HerrRiebmann/KDS2Bluetooth/ECU Emulation/Hex Calculator/Resources/AddFile.png

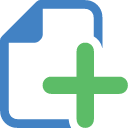
ECU Emulation/Hex Calculator/Resources/AddFile.png
