HerrRiebmann/KDS2Bluetooth/ECU Emulation/Images/Hex Reader.png

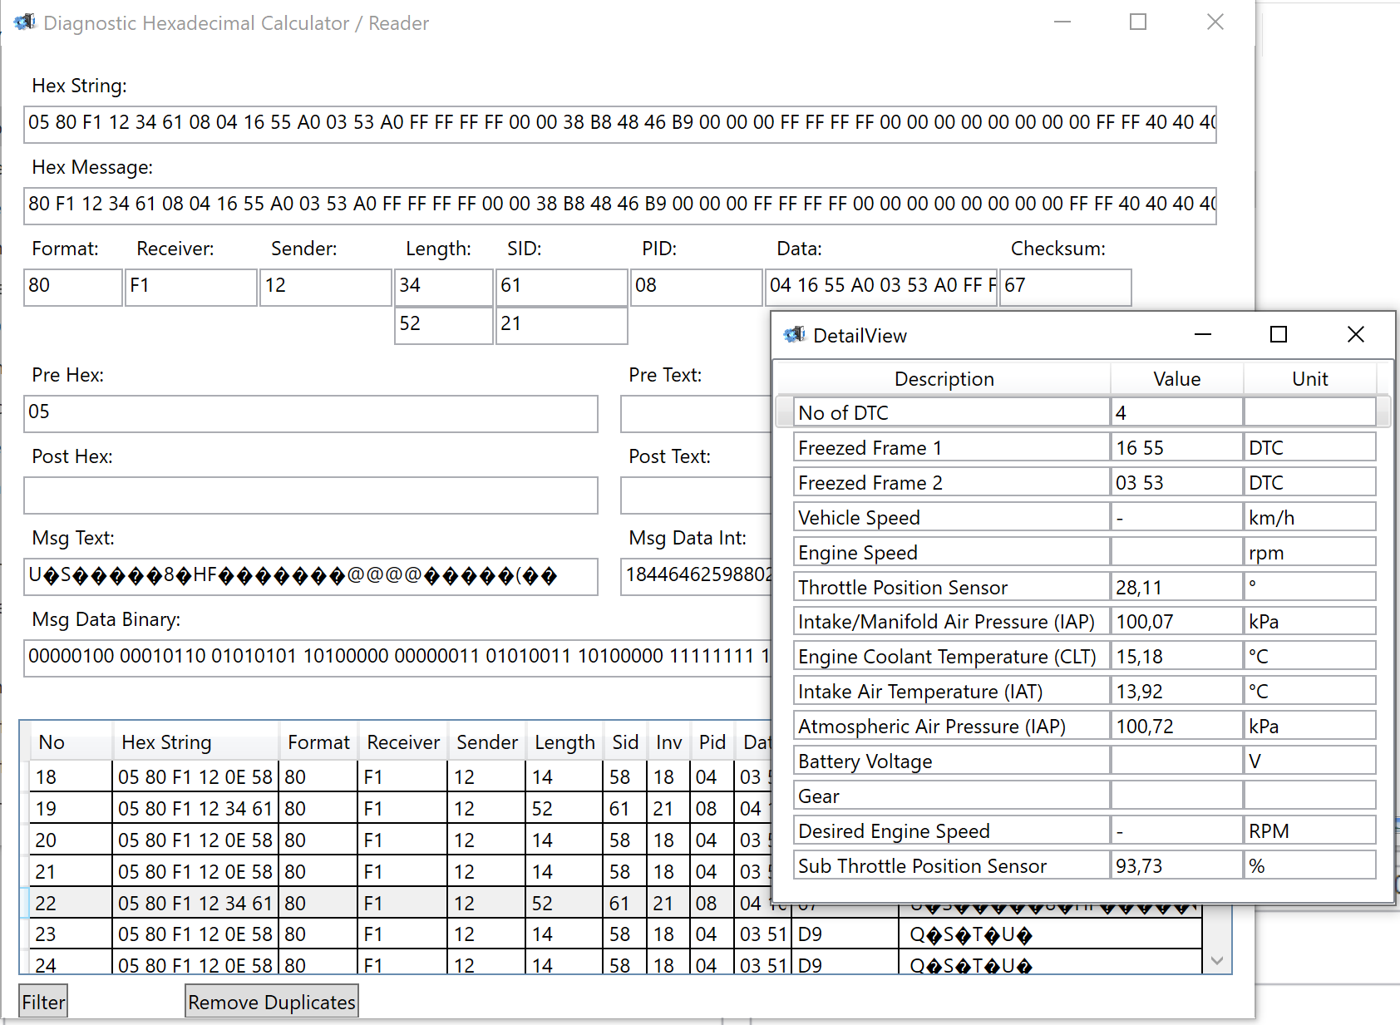
ECU Emulation/Images/Hex Reader.png
