HerrRiebmann/KDS2Bluetooth/ECU Emulation/Images/obd2 compliant.png

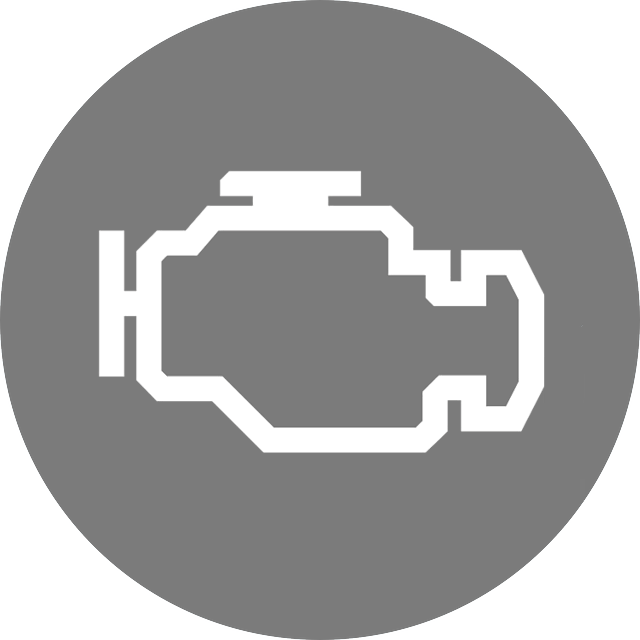
ECU Emulation/Images/obd2 compliant.png
