HerrRiebmann/KDS2Bluetooth/ECU Emulation/Images/vspc-2.gif

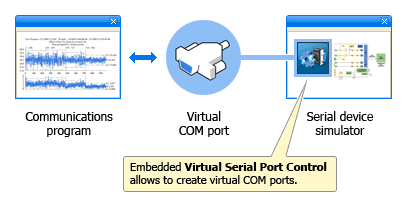
ECU Emulation/Images/vspc-2.gif
