HerrRiebmann/KDS2Bluetooth/Documentation/OBD II PIDs.xlsx

Sheet: Wikipedia
PID (hex) | Data bytes returned | Description | Min value | Max value | Units | Formula[a] (https://en.wikipedia.org/wiki/OBD-II_PIDs) | Number | Kawasaki
0 | 4 | PIDs supported [01 - 20] |  |  |  | Bit encoded [A7..D0] == [PID $01..PID $20] See below (https://en.wikipedia.org/wiki/OBD-II_PIDs)
1 | 4 | Monitor status since DTCs cleared. (Includes malfunction indicator lamp (MIL) status and number of DTCs.) |  |  |  | Bit encoded. See below (https://en.wikipedia.org/wiki/OBD-II_PIDs) | 1 |  | 0
2 | 2 | Freeze DTC |  |  |  |  | 2 |  | 0
3 | 2 | Fuel system status |  |  |  | Bit encoded. See below (https://en.wikipedia.org/wiki/OBD-II_PIDs) | 3 |  | 0
4 | 1 | Calculated engine load value | 0 | 100 | % | A*100/255 | 4 |  | 0
5 | 1 | Engine coolant temperature | -40 | 215 | °C | A-40 | 5 | 6 | 1
6 | 1 | Short term fuel % trim—Bank 1 | -100 Subtracting Fuel (Rich Condition) | 99.22 Adding Fuel (Lean Condition) | % | (A-128) * 100/128 | 6 |  | 0
7 | 1 | Long term fuel % trim—Bank 1 | -100 Subtracting Fuel (Rich Condition) | 99.22 Adding Fuel (Lean Condition) | % | (A-128) * 100/128 | 7 |  | 0
8 | 1 | Short term fuel % trim—Bank 2 | -100 Subtracting Fuel (Rich Condition) | 99.22 Adding Fuel (Lean Condition) | % | (A-128) * 100/128 | 8 |  | 0
9 | 1 | Long term fuel % trim—Bank 2 | -100 Subtracting Fuel (Rich Condition) | 99.22 Adding Fuel (Lean Condition) | % | (A-128) * 100/128 | 9 |  | 0
0A | 1 | Fuel pressure | 0 | 765 | kPa (gauge) | A*3 | 10 |  | 0
0B | 1 | Intake manifold absolute pressure | 0 | 255 | kPa (absolute) | A | 11 | 5 | 1 | ?
0C | 2 | Engine RPM | 0 | 16,383.75 | rpm | ((A*256)+B)/4 | 12 | 9 | 1
0D | 1 | Vehicle speed | 0 | 255 | km/h | A | 13 | 0C | 1
0E | 1 | Timing advance | -64 | 63.5 | ° relative to #1 cylinder | (A-128)/2 | 14 |  | 0
0F | 1 | Intake air temperature | -40 | 215 | °C | A-40 | 15 | 7 | 1
10 | 2 | MAF air flow rate | 0 | 655.35 | grams/sec | ((A*256)+B) / 100 | 16 |  | 0 | ? | Fehlt das Pendant bei Kawa
11 | 1 | Throttle position | 0 | 100 | % | A*100/255 | 17 | 4 | 1
12 | 1 | Commanded secondary air status |  |  |  | Bit encoded. See below (https://en.wikipedia.org/wiki/OBD-II_PIDs) | 18 |  | 0
13 | 1 | Oxygen sensors present |  |  |  | [A0..A3] == Bank 1, Sensors 1-4. [A4..A7] == Bank 2... | 19 |  | 0
14 | 2 | Bank 1, Sensor 1: |  |  | Volts | A/200
 |  | Oxygen sensor voltage, | 0 | 1.275 | % | (B-128) * 100/128 (if B==$FF, sensor is not used in trim calc) | 20 |  | 0
 |  | Short term fuel trim | -100(lean) | 99.2(rich)
15 | 2 | Bank 1, Sensor 2: |  |  | Volts | A/200
 |  | Oxygen sensor voltage, | 0 | 1.275 | % | (B-128) * 100/128 (if B==$FF, sensor is not used in trim calc) | 21 |  | 0
 |  | Short term fuel trim | -100(lean) | 99.2(rich)
16 | 2 | Bank 1, Sensor 3: |  |  | Volts | A/200
 |  | Oxygen sensor voltage, | 0 | 1.275 | % | (B-128) * 100/128 (if B==$FF, sensor is not used in trim calc) | 22 |  | 0
 |  | Short term fuel trim | -100(lean) | 99.2(rich)
17 | 2 | Bank 1, Sensor 4: |  |  | Volts | A/200
 |  | Oxygen sensor voltage, | 0 | 1.275 | % | (B-128) * 100/128 (if B==$FF, sensor is not used in trim calc) | 23 |  | 0
 |  | Short term fuel trim | -100(lean) | 99.2(rich)
18 | 2 | Bank 2, Sensor 1: |  |  | Volts | A/200
 |  | Oxygen sensor voltage, | 0 | 1.275 | % | (B-128) * 100/128 (if B==$FF, sensor is not used in trim calc) | 24 |  | 0
 |  | Short term fuel trim | -100(lean) | 99.2(rich)
19 | 2 | Bank 2, Sensor 2: |  |  | Volts | A/200
 |  | Oxygen sensor voltage, | 0 | 1.275 | % | (B-128) * 100/128 (if B==$FF, sensor is not used in trim calc) | 25 |  | 0
 |  | Short term fuel trim | -100(lean) | 99.2(rich)
1A | 2 | Bank 2, Sensor 3: |  |  | Volts | A/200
 |  | Oxygen sensor voltage, | 0 | 1.275 | % | (B-128) * 100/128 (if B==$FF, sensor is not used in trim calc) | 26 |  | 0
 |  | Short term fuel trim | -100(lean) | 99.2(rich)
1B | 2 | Bank 2, Sensor 4: |  |  | Volts | A/200
 |  | Oxygen sensor voltage, | 0 | 1.275 | % | (B-128) * 100/128 (if B==$FF, sensor is not used in trim calc) | 27 |  | 0
 |  | Short term fuel trim | -100(lean) | 99.2(rich)
1C | 1 | OBD standards this vehicle conforms to |  |  |  | Bit encoded. See below (https://en.wikipedia.org/wiki/OBD-II_PIDs)
1D | 1 | Oxygen sensors present |  |  |  | Similar to PID 13, but [A0..A7] == [B1S1, B1S2, B2S1, B2S2, B3S1, B3S2, B4S1, B4S2] | 28 |  | 0
1E | 1 | Auxiliary input status |  |  |  | A0 == Power Take Off (PTO) status (1 == active) | 29 |  | 0
 |  |  |  |  |  | [A1..A7] not used
1F | 2 | Run time since engine start | 0 | 65.535 | seconds | (A*256)+B | 30 |  | 0
20 | 4 | PIDs supported [21 - 40] |  |  |  | Bit encoded [A7..D0] == [PID $21..PID $40] See below (https://en.wikipedia.org/wiki/OBD-II_PIDs)
21 | 2 | Distance traveled with malfunction indicator lamp (MIL) on | 0 | 65.535 | km | (A*256)+B | 1
22 | 2 | Fuel Rail Pressure (relative to manifold vacuum) | 0 | 5177265 | kPa | ((A*256)+B) * 0.079 | 2
23 | 2 | Fuel Rail Pressure (diesel, or gasoline direct inject) | 0 | 655.35 | kPa (gauge) | ((A*256)+B) * 10 | 3
24 | 4 | O2S1_WR_lambda(1): | 0 | 1999 | N/A | ((A*256)+B)*2/65535 or ((A*256)+B)/32768
 |  | Equivalence Ratio | 0 | 7999 | V | ((C*256)+D)*8/65535 or ((C*256)+D)/8192 | 4
 |  | Voltage
25 | 4 | O2S2_WR_lambda(1): | 0 | 2 | N/A | ((A*256)+B)*2/65535 | 5
 |  | Equivalence Ratio | 0 | 8 | V | ((C*256)+D)*8/65535
 |  | Voltage
26 | 4 | O2S3_WR_lambda(1): | 0 | 2 | N/A | ((A*256)+B)*2/65535
 |  | Equivalence Ratio | 0 | 8 | V | ((C*256)+D)*8/65535 | 6
 |  | Voltage
27 | 4 | O2S4_WR_lambda(1): | 0 | 2 | N/A | ((A*256)+B)*2/65535 | 7
 |  | Equivalence Ratio | 0 | 8 | V | ((C*256)+D)*8/65535
 |  | Voltage
28 | 4 | O2S5_WR_lambda(1): | 0 | 2 | N/A | ((A*256)+B)*2/65535
 |  | Equivalence Ratio | 0 | 8 | V | ((C*256)+D)*8/65535 | 8
 |  | Voltage
29 | 4 | O2S6_WR_lambda(1): | 0 | 2 | N/A | ((A*256)+B)*2/65535
 |  | Equivalence Ratio | 0 | 8 | V | ((C*256)+D)*8/65535 | 9
 |  | Voltage
2A | 4 | O2S7_WR_lambda(1): | 0 | 2 | N/A | ((A*256)+B)*2/65535
 |  | Equivalence Ratio | 0 | 8 | V | ((C*256)+D)*8/65535 | 10
 |  | Voltage
2B | 4 | O2S8_WR_lambda(1): | 0 | 2 | N/A | ((A*256)+B)*2/65535
 |  | Equivalence Ratio | 0 | 8 | V | ((C*256)+D)*8/65535 | 11
 |  | Voltage
2C | 1 | Commanded EGR (https://en.wikipedia.org/wiki/Exhaust_gas_recirculation) | 0 | 100 | % | A*100/255 | 12
2D | 1 | EGR Error | -100 | 99.22 | % | (A-128) * 100/128 | 13
2E | 1 | Commanded evaporative purge | 0 | 100 | % | A*100/255 | 14
2F | 1 | Fuel Level Input | 0 | 100 | % | A*100/255 | 15
30 | 1 | # of warm-ups since codes cleared | 0 | 255 | N/A | A | 16
31 | 2 | Distance traveled since codes cleared | 0 | 65.535 | km | (A*256)+B | 17
32 | 2 | Evap. System Vapor Pressure | -8.192 | 8.192 | Pa | ((A*256)+B)/4 (A and B are two's complement signed) (https://en.wikipedia.org/wiki/Two%27s_complement) | 18
33 | 1 | Barometric pressure | 0 | 255 | kPa (Absolute) | A | 19
34 | 4 | O2S1_WR_lambda(1): | 0 | 1999 | N/A | ((A*256)+B)/32,768 | 20
 |  | Equivalence Ratio | -128 | 127.99 | mA | ((C*256)+D)/256 - 128
 |  | Current
35 | 4 | O2S2_WR_lambda(1): | 0 | 2 | N/A | ((A*256)+B)/32,768 | 21
 |  | Equivalence Ratio | -128 | 128 | mA | ((C*256)+D)/256 - 128
 |  | Current
36 | 4 | O2S3_WR_lambda(1): | 0 | 2 | N/A | ((A*256)+B)/32768
 |  | Equivalence Ratio | -128 | 128 | mA | ((C*256)+D)/256 - 128
 |  | Current
37 | 4 | O2S4_WR_lambda(1): | 0 | 2 | N/A | ((A*256)+B)/32,768 | 22
 |  | Equivalence Ratio | -128 | 128 | mA | ((C*256)+D)/256 - 128
 |  | Current
38 | 4 | O2S5_WR_lambda(1): | 0 | 2 | N/A | ((A*256)+B)/32,768 | 23
 |  | Equivalence Ratio | -128 | 128 | mA | ((C*256)+D)/256 - 128
 |  | Current
39 | 4 | O2S6_WR_lambda(1): | 0 | 2 | N/A | ((A*256)+B)/32,768 | 24
 |  | Equivalence Ratio | -128 | 128 | mA | ((C*256)+D)/256 - 128
 |  | Current
3A | 4 | O2S7_WR_lambda(1): | 0 | 2 | N/A | ((A*256)+B)/32,768 | 25
 |  | Equivalence Ratio | -128 | 128 | mA | ((C*256)+D)/256 - 128
 |  | Current
3B | 4 | O2S8_WR_lambda(1): | 0 | 2 | N/A | ((A*256)+B)/32,768 | 26
 |  | Equivalence Ratio | -128 | 128 | mA | ((C*256)+D)/256 - 128
 |  | Current
3C | 2 | Catalyst Temperature | -40 | 6,513.5 | °C | ((A*256)+B)/10 - 40 | 27
 |  | Bank 1, Sensor 1
3D | 2 | Catalyst Temperature | -40 | 6,513.5 | °C | ((A*256)+B)/10 - 40 | 28
 |  | Bank 2, Sensor 1
3E | 2 | Catalyst Temperature | -40 | 6,513.5 | °C | ((A*256)+B)/10 - 40 | 29
 |  | Bank 1, Sensor 2
3F | 2 | Catalyst Temperature | -40 | 6,513.5 | °C | ((A*256)+B)/10 - 40 | 30
 |  | Bank 2, Sensor 2
40 | 4 | PIDs supported [41 - 60] |  |  |  | Bit encoded [A7..D0] == [PID $41..PID $60] See below (https://en.wikipedia.org/wiki/OBD-II_PIDs)
41 | 4 | Monitor status this drive cycle |  |  |  | Bit encoded. See below (https://en.wikipedia.org/wiki/OBD-II_PIDs) | 1
42 | 2 | Control module voltage | 0 | 65535 | V | ((A*256)+B)/1000 | 2
43 | 2 | Absolute load value | 0 | 25.7 | % | ((A*256)+B)*100/255 | 3
44 | 2 | Fuel/Air commanded equivalence ratio | 0 | 2 | N/A | ((A*256)+B)/32768 | 4
45 | 1 | Relative throttle position | 0 | 100 | % | A*100/255 | 5
46 | 1 | Ambient air temperature | -40 | 215 | °C | A-40 | 6
47 | 1 | Absolute throttle position B | 0 | 100 | % | A*100/255 | 7
48 | 1 | Absolute throttle position C | 0 | 100 | % | A*100/255 | 8
49 | 1 | Accelerator pedal position D | 0 | 100 | % | A*100/255 | 9
4A | 1 | Accelerator pedal position E | 0 | 100 | % | A*100/255 | 10
4B | 1 | Accelerator pedal position F | 0 | 100 | % | A*100/255 | 11
4C | 1 | Commanded throttle actuator | 0 | 100 | % | A*100/255 | 12
4D | 2 | Time run with MIL on | 0 | 65.535 | minutes | (A*256)+B | 13
4E | 2 | Time since trouble codes cleared | 0 | 65.535 | minutes | (A*256)+B | 14
4F | 4 | Maximum value for equivalence ratio, oxygen sensor voltage, oxygen sensor current, and intake manifold absolute pressure | 0, 0, 0, 0 | 255, 255, 255, 2550 | , V, mA, kPa | A, B, C, D*10 | 15
50 | 4 | Maximum value for air flow rate from mass air flow sensor | 0 | 2550 | g/s | A*10, B, C, and D are reserved for future use | 16
51 | 1 | Fuel Type |  |  |  | From fuel type table see below (https://en.wikipedia.org/wiki/OBD-II_PIDs) | 17
52 | 1 | Ethanol fuel % | 0 | 100 | % | A*100/255 | 18
53 | 2 | Absolute Evap system Vapor Pressure | 0 | 327675 | kPa | ((A*256)+B)/200 | 19
54 | 2 | Evap system vapor pressure | -32.767 | 32.768 | Pa | ((A*256)+B)-32767 | 20
55 | 2 | Short term secondary oxygen sensor trim bank 1 and bank 3 | -100 | 99.22 | % | (A-128)*100/128 | 21
 |  |  |  |  |  | (B-128)*100/128
56 | 2 | Long term secondary oxygen sensor trim bank 1 and bank 3 | -100 | 99.22 | % | (A-128)*100/128 | 22
 |  |  |  |  |  | (B-128)*100/128
57 | 2 | Short term secondary oxygen sensor trim bank 2 and bank 4 | -100 | 99.22 | % | (A-128)*100/128 | 23
 |  |  |  |  |  | (B-128)*100/128
58 | 2 | Long term secondary oxygen sensor trim bank 2 and bank 4 | -100 | 99.22 | % | (A-128)*100/128 | 24
 |  |  |  |  |  | (B-128)*100/128
59 | 2 | Fuel rail pressure (absolute) | 0 | 655.35 | kPa | ((A*256)+B) * 10 | 25
5A | 1 | Relative accelerator pedal position | 0 | 100 | % | A*100/255 | 26
5B | 1 | Hybrid battery pack remaining life | 0 | 100 | % | A*100/255 | 27
5C | 1 | Engine oil temperature | -40 | 210 | °C | A - 40 | 28
5D | 2 | Fuel injection timing | -210.00 | 301992 | ° | (((A*256)+B)-26,880)/128 | 29
5E | 2 | Engine fuel rate | 0 | 3212.75 | L/h | ((A*256)+B)*0.05 | 30 |  | ?
5F | 1 | Emission requirements to which vehicle is designed |  |  |  | Bit Encoded | 31
60 | 4 | PIDs supported [61 - 80] |  |  |  | Bit encoded [A7..D0] == [PID $61..PID $80] See below (https://en.wikipedia.org/wiki/OBD-II_PIDs)
61 | 1 | Driver's demand engine - percent torque | -125 | 125 | % | A-125 | 1
62 | 1 | Actual engine - percent torque | -125 | 125 | % | A-125 | 2 |  | ?
63 | 2 | Engine reference torque | 0 | 65.535 | Nm | A*256+B | 3
64 | 5 | Engine percent torque data | -125 | 125 | % | A-125 Idle
 |  |  |  |  |  | B-125 Engine point 1 | 4
 |  |  |  |  |  | C-125 Engine point 2
 |  |  |  |  |  | D-125 Engine point 3
 |  |  |  |  |  | E-125 Engine point 4
65 | 2 | Auxiliary input / output supported |  |  |  | Bit Encoded | 5
66 | 5 | Mass air flow sensor |  |  |  |  | 6
67 | 3 | Engine coolant temperature |  |  |  |  | 7
68 | 7 | Intake air temperature sensor |  |  |  |  | 8
69 | 7 | Commanded EGR and EGR Error |  |  |  |  | 9
6A | 5 | Commanded Diesel intake air flow control and relative intake air flow position |  |  |  |  | 10
6B | 5 | Exhaust gas recirculation temperature |  |  |  |  | 11
6C | 5 | Commanded throttle actuator control and relative throttle position |  |  |  |  | 12
6D | 6 | Fuel pressure control system |  |  |  |  | 13
6E | 5 | Injection pressure control system |  |  |  |  | 14
6F | 3 | Turbocharger compressor inlet pressure |  |  |  |  | 15
70 | 9 | Boost pressure control |  |  |  |  | 16
71 | 5 | Variable Geometry turbo (VGT) control |  |  |  |  | 17
72 | 5 | Wastegate control |  |  |  |  | 18
73 | 5 | Exhaust pressure |  |  |  |  | 19
74 | 5 | Turbocharger RPM |  |  |  |  | 20
75 | 7 | Turbocharger temperature |  |  |  |  | 21
76 | 7 | Turbocharger temperature |  |  |  |  | 22
77 | 5 | Charge air cooler temperature (CACT) |  |  |  |  | 23
78 | 9 | Exhaust Gas temperature (EGT) Bank 1 |  |  |  | Special PID. See below (https://en.wikipedia.org/wiki/OBD-II_PIDs) | 24
79 | 9 | Exhaust Gas temperature (EGT) Bank 2 |  |  |  | Special PID. See below (https://en.wikipedia.org/wiki/OBD-II_PIDs) | 25
7A | 7 | Diesel particulate filter (DPF) |  |  |  |  | 26
7B | 7 | Diesel particulate filter (DPF) |  |  |  |  | 27
7C | 9 | Diesel Particulate filter (DPF) temperature |  |  |  |  | 28
7D | 1 | NOx NTE control area status |  |  |  |  | 29
7E | 1 | PM NTE control area status |  |  |  |  | 30
7F | 13 | Engine run time
80 | 4 | PIDs supported [81 - A0] |  |  |  | Bit encoded [A7..D0] == [PID $81..PID $A0] See below (https://en.wikipedia.org/wiki/OBD-II_PIDs)
81 | 21 | Engine run time for Auxiliary Emissions Control Device(AECD) |  |  |  |  | 1
82 | 21 | Engine run time for Auxiliary Emissions Control Device(AECD) |  |  |  |  | 2
83 | 5 | NOx sensor |  |  |  |  | 3
84 |  | Manifold surface temperature |  |  |  |  | 4
85 |  | NOx reagent system |  |  |  |  | 5
86 |  | Particulate matter (PM) sensor |  |  |  |  | 6
87 |  | Intake manifold absolute pressure |  |  |  |  | 7
A0 | 4 | PIDs supported [A1 - C0] |  |  |  | Bit encoded [A7..D0] == [PID $A1..PID $C0] See below (https://en.wikipedia.org/wiki/OBD-II_PIDs) | 8
C0 | 4 | PIDs supported [C1 - E0] |  |  |  | Bit encoded [A7..D0] == [PID $C1..PID $E0] See below (https://en.wikipedia.org/wiki/OBD-II_PIDs) | 9
C3 | ? | ? | ? | ? | ? | Returns numerous data, including Drive Condition ID and Engine Speed* | 10
C4 | ? | ? | ? | ? | ? | B5 is Engine Idle Request | 11
 |  |  |  |  |  | B6 is Engine Stop Request*

Sheet: OBD II PID
PID | No. | Description | Data bytes returned | Min value | Max value | Units | Formula[a] | Kawasaki PID | Garmin Virb
0 | 0 | List of PIDs supported (range 01 to 32) | 4 |  |  |  | Bit encoded [A7..D0] == [PID $01..PID $20] See below
1 | 1 | Status since the last clearing of fault codes | 4 |  |  |  | Bit encoded. See below |  |  | 0
2 | 2 | Fault code that caused the recording of "freeze frame" data | 2 |  |  |  |  |  |  | 0
3 | 3 | Fuel system status | 2 |  |  |  | Bit encoded. See below |  |  | 0
4 | 4 | Engine load calculated in % | 1 | 0 | 100 | % | A*100/255 |  | X | 1
5 | 5 | Temperature of the engine coolant in Â°C | 1 | -40 | 215 | °C | A-40 | 6 | X | 1
6 | 6 | Short-term fuel % trim bank 1 | 1 | -100 Subtracting Fuel (Rich Condition) | 99.22 Adding Fuel (Lean Condition) | % | (A-128) * 100/128 |  |  | 0
7 | 7 | Long-term fuel % trim bank 1 | 1 | -100 Subtracting Fuel (Rich Condition) | 99.22 Adding Fuel (Lean Condition) | % | (A-128) * 100/128 |  |  | 0
8 | 8 | Short-term fuel % trim bank 2 | 1 | -100 Subtracting Fuel (Rich Condition) | 99.22 Adding Fuel (Lean Condition) | % | (A-128) * 100/128 |  |  | 0
9 | 9 | Long-term fuel % trim bank 2 | 1 | -100 Subtracting Fuel (Rich Condition) | 99.22 Adding Fuel (Lean Condition) | % | (A-128) * 100/128 |  |  | 0
0A | 10 | Fuel pressure in kPa | 1 | 0 | 765 | kPa (gauge) | A*3 |  |  | 0
0B | 11 | Intake manifold absolute pressure in kPa | 1 | 0 | 255 | kPa (absolute) | A | 5 |  | 0
0C | 12 | Engine speed in rpm | 2 | 0 | 16,383.75 | rpm | ((A*256)+B)/4 | 9 | X | 1
0D | 13 | Vehicle speed in kph | 1 | 0 | 255 | km/h | A | 0C | X | 1
0E | 14 | Timing advance on cylinder 1 in degrees | 1 | -64 | 63.5 | ° relative to #1 cylinder | (A-128)/2 |  |  | 0
0F | 15 | Intake air temperature in Â°C | 1 | -40 | 215 | °C | A-40 | 7 | X | 1
10 | 16 | Air flow measured by the flowmeter in g/s | 2 | 0 | 655.35 | grams/sec | ((A*256)+B) / 100 | MAF | X | 1
11 | 17 | Throttle position in % | 1 | 0 | 100 | % | A*100/255 | 4 | X | 1
12 | 18 | Status of the secondary intake circuit | 1 |  |  |  | Bit encoded. See below |  |  | 0
13 | 19 | O2 sensor positions bank/sensor | 1 |  |  |  | [A0..A3] == Bank 1, Sensors 1-4. [A4..A7] == Bank 2... |  |  | 0
14 | 20 | Oxygen sensor volts bank 1 sensor 1 | 2 | 0 | 1.275 | % | (B-128) * 100/128 (if B==$FF, sensor is not used in trim calc) |  |  | 0
15 | 21 | Oxygen sensor volts bank 1 sensor 2 | 2 | 0 | 1.275 | % | (B-128) * 100/128 (if B==$FF, sensor is not used in trim calc) |  |  | 0
16 | 22 | Oxygen sensor volts bank 1 sensor 3 | 2 | 0 | 1.275 | % | (B-128) * 100/128 (if B==$FF, sensor is not used in trim calc) |  |  | 0
17 | 23 | Oxygen sensor volts bank 1 sensor 4 | 2 | 0 | 1.275 | % | (B-128) * 100/128 (if B==$FF, sensor is not used in trim calc) |  |  | 0
18 | 24 | Oxygen sensor volts bank 2 sensor 1 | 2 | 0 | 1.275 | % | (B-128) * 100/128 (if B==$FF, sensor is not used in trim calc) |  |  | 0
19 | 25 | Oxygen sensor volts bank 2 sensor 2 | 2 | 0 | 1.275 | % | (B-128) * 100/128 (if B==$FF, sensor is not used in trim calc) |  |  | 0
1A | 26 | Oxygen sensor volts bank 2 sensor 3 | 2 | 0 | 1.275 | % | (B-128) * 100/128 (if B==$FF, sensor is not used in trim calc) |  |  | 0
1B | 27 | Oxygen sensor volts bank 2 sensor 4 | 2 | 0 | 1.275 | % | (B-128) * 100/128 (if B==$FF, sensor is not used in trim calc) |  |  | 0
1C | 28 | OBD computer specification | 1 |  |  |  |  |  |  | 0
1D | 29 | O2 sensor positions bank/sensor | 1 |  |  |  | Similar to PID 13, but [A0..A7] == [B1S1, B1S2, B2S1, B2S2, B3S1, B3S2, B4S1, B4S2] |  |  | 0
1E | 30 | Auxiliary input status | 1 |  |  |  | A0 == Power Take Off (PTO) status (1 == active) |  |  | 0
1F | 31 | Run time since engine start | 2 | 0 | 65.535 | seconds | (A*256)+B |  |  | 0
20 | 32 | List of PIDs supported (range 33 to 64) | 4 |  |  |  | Bit encoded [A7..D0] == [PID $21..PID $40] See below |  |  | 1 | 4100181B8001
21 | 33 | Distance travelled with MIL on in kms | 2 | 0 | 65.535 | km | (A*256)+B |  |  | 0
22 | 34 | Relative fuel rail pressure in kPa | 2 | 0 | 5177265 | kPa | ((A*256)+B) * 0.079 |  |  | 0
23 | 35 | Fuel rail pressure in kPa | 2 | 0 | 655.35 | kPa (gauge) | ((A*256)+B) * 10 |  |  | 0
24 | 36 | O2 sensor (extended range) bank 1, sensor 1 (lambda and volts) | 4 | 0 | 7999 | V | ((C*256)+D)*8/65535 or ((C*256)+D)/8192 |  |  | 0
25 | 37 | O2 sensor (extended range) bank 1, sensor 2 (lambda and volts) | 4 | 0 | 8 | V | ((C*256)+D)*8/65535 |  |  | 0
26 | 38 | O2 sensor (extended range) bank 1, sensor 3 (lambda and volts) | 4 | 0 | 8 | V | ((C*256)+D)*8/65535 |  |  | 0
27 | 39 | O2 sensor (extended range) bank 1, sensor 4 (lambda and volts) | 4 | 0 | 8 | V | ((C*256)+D)*8/65535 |  |  | 0
28 | 40 | O2 sensor (extended range) bank 2, sensor 1 (lambda and volts) | 4 | 0 | 8 | V | ((C*256)+D)*8/65535 |  |  | 0
29 | 41 | O2 sensor (extended range) bank 2, sensor 2 (lambda and volts) | 4 | 0 | 8 | V | ((C*256)+D)*8/65535 |  |  | 0
2A | 42 | O2 sensor (extended range) bank 2, sensor 3 (lambda and volts) | 4 | 0 | 8 | V | ((C*256)+D)*8/65535 |  |  | 0
2B | 43 | O2 sensor (extended range) bank 2, sensor 4 (lambda and volts) | 4 | 0 | 8 | V | ((C*256)+D)*8/65535 |  |  | 0
2C | 44 | EGR in % | 1 | 0 | 100 | % | A*100/255 |  |  | 0
2D | 45 | EGR error in % | 1 | -100 | 99.22 | % | (A-128) * 100/128 |  |  | 0
2E | 46 | Evaporation purge in % | 1 | 0 | 100 | % | A*100/255 |  |  | 0
2F | 47 | Fuel level in % | 1 | 0 | 100 | % | A*100/255 |  |  | 0
30 | 48 | Number of warning(s) since faults (DTC) were cleared | 1 | 0 | 255 | N/A | A |  |  | 0
31 | 49 | Distance since faults (DTC) were cleared. | 2 | 0 | 65.535 | km | (A*256)+B |  |  | 0
32 | 50 | Evaporation system vapour pressure in Pa | 2 | -8.192 | 8.192 | Pa | ((A*256)+B)/4 (A and B are two's complement signed) |  |  | 0
33 | 51 | Barometic pressure in kPa | 1 | 0 | 255 | kPa (Absolute) | A |  |  | 0
34 | 52 | O2 sensor (extended range) bank 1, sensor 1 (lambda and volts) | 4 | -128 | 127.99 | mA | ((C*256)+D)/256 - 128 |  |  | 0
35 | 53 | O2 sensor (extended range) bank 1, sensor 2 (lambda and volts) | 4 | -128 | 128 | mA | ((C*256)+D)/256 - 128 |  |  | 0
36 | 54 | O2 sensor (extended range) bank 1, sensor 3 (lambda and volts) | 4 | -128 | 128 | mA | ((C*256)+D)/256 - 128 |  |  | 0
37 | 55 | O2 sensor (extended range) bank 1, sensor 4 (lambda and volts) | 4 | -128 | 128 | mA | ((C*256)+D)/256 - 128 |  |  | 0
38 | 56 | O2 sensor (extended range) bank 2, sensor 1 (lambda and volts) | 4 | -128 | 128 | mA | ((C*256)+D)/256 - 128 |  |  | 0
39 | 57 | O2 sensor (extended range) bank 2, sensor 2 (lambda and volts) | 4 | -128 | 128 | mA | ((C*256)+D)/256 - 128 |  |  | 0
3A | 58 | O2 sensor (extended range) bank 2, sensor 3 (lambda and volts) | 4 | -128 | 128 | mA | ((C*256)+D)/256 - 128 |  |  | 0
3B | 59 | O2 sensor (extended range) bank 2, sensor 4 (lambda and volts) | 4 | -128 | 128 | mA | ((C*256)+D)/256 - 128 |  |  | 0
3C | 60 | Catalyst temperature in Â°C bank 1, sensor 1 | 2 | -40 | 6,513.5 | °C | ((A*256)+B)/10 - 40 |  |  | 0
3D | 61 | Catalyst temperature in Â°C bank 2, sensor 1 | 2 | -40 | 6,513.5 | °C | ((A*256)+B)/10 - 40 |  |  | 0
3E | 62 | Catalyst temperature in Â°C bank 1, sensor 2 | 2 | -40 | 6,513.5 | °C | ((A*256)+B)/10 - 40 |  |  | 0
3F | 63 | Catalyst temperature in Â°C bank 2, sensor 1 | 2 | -40 | 6,513.5 | °C | ((A*256)+B)/10 - 40 |  |  | 0
40 | 64 | List of PIDs supported (range 65 to 96) | 4 |  |  |  | Bit encoded [A7..D0] == [PID $41..PID $60] See below |  |  | 1 | 412000000001
41 | 65 | Monitor status this drive cycle | 4 |  |  |  | Bit encoded. See below |  |  | 0
42 | 66 | Control module voltage in V | 2 | 0 | 65535 | V | ((A*256)+B)/1000 |  |  | 0
43 | 67 | Absolute engine load | 2 | 0 | 25.7 | % | ((A*256)+B)*100/255 |  |  | 0
44 | 68 | Equivalent fuel/air mixture request | 2 | 0 | 2 | N/A | ((A*256)+B)/32768 |  |  | 0
45 | 69 | Relative throttle position in % | 1 | 0 | 100 | % | A*100/255 |  | X | 1
46 | 70 | Ambient air temperature in Â°C | 1 | -40 | 215 | °C | A-40 |  |  | 0
47 | 71 | Absolute throttle position B in % | 1 | 0 | 100 | % | A*100/255 |  |  | 0
48 | 72 | Absolute throttle position C in % | 1 | 0 | 100 | % | A*100/255 |  |  | 0
49 | 73 | Accelerator pedal position D in % | 1 | 0 | 100 | % | A*100/255 |  |  | 0
4A | 74 | Accelerator pedal position E in % | 1 | 0 | 100 | % | A*100/255 |  |  | 0
4B | 75 | Accelerator pedal position F in % | 1 | 0 | 100 | % | A*100/255 |  |  | 0
4C | 76 | Commanded throttle actuator in % | 1 | 0 | 100 | % | A*100/255 |  |  | 0
4D | 77 | Engine run time since MIL on in min | 2 | 0 | 65.535 | minutes | (A*256)+B |  |  | 0
4E | 78 | Engine run time since faults cleared in min | 2 | 0 | 65.535 | minutes | (A*256)+B |  |  | 0
4F | 79 | Exteral test equipment no. 1 configuration information | 4 | 0, 0, 0, 0 | 255, 255, 255, 2550 | , V, mA, kPa | A, B, C, D*10 |  |  | 0
50 | 80 | Exteral test equipment no. 2 configuration information | 4 | 0 | 2550 | g/s | A*10, B, C, and D are reserved for future use |  |  | 0
51 | 81 | Fuel type used by the vehicle | 1 |  |  |  | From fuel type table see below |  |  | 0
52 | 82 | Ethanol fuel % | 1 | 0 | 100 | % | A*100/255 |  |  | 0
53 | 83 | Absolute evaporation system vapour pressure in kPa | 2 | 0 | 327675 | kPa | ((A*256)+B)/200 |  |  | 0
54 | 84 | Evaporation system vapour pressure in Pa | 2 | -32.767 | 32.768 | Pa | ((A*256)+B)-32767 |  |  | 0
55 | 85 | Short-term O2 sensor trim bank 1 and 3 | 2 | -100 | 99.22 | % | (A-128)*100/128 |  |  | 0
56 | 86 | Long-term O2 sensor trim bank 1 and 3 | 2 | -100 | 99.22 | % | (A-128)*100/128 |  |  | 0
57 | 87 | Short-term O2 sensor trim bank 2 and 4 | 2 | -100 | 99.22 | % | (A-128)*100/128 |  |  | 0
58 | 88 | Long-term O2 sensor trim bank 2 and 4 | 2 | -100 | 99.22 | % | (A-128)*100/128 |  |  | 0
59 | 89 | Absolute fuel rail pressure in kPa | 2 | 0 | 655.35 | kPa | ((A*256)+B) * 10 |  |  | 0
5A | 90 | Relative accelerator pedal position in % | 1 | 0 | 100 | % | A*100/255 |  |  | 0
5B | 91 | Battery unit remaining life (hybrid) in % | 1 | 0 | 100 | % | A*100/255 |  |  | 0
5C | 92 | Engine oil temperature in Â°C | 1 | -40 | 210 | °C | A - 40 |  |  | 0
5D | 93 | Fuel injection timing in Â° | 2 | -210.00 | 301992 | ° | (((A*256)+B)-26,880)/128 |  |  | 0
5E | 94 | Fuel consumption in litre/hr | 2 | 0 | 3212.75 | L/h | ((A*256)+B)*0.05 |  |  | 0
5F | 95 | Fuel consumption in litre/hr | 1 |  |  |  | Bit Encoded |  |  | 0
60 | 96 | List of PIDs supported (range 97 to 128) | 4 |  |  |  | Bit encoded [A7..D0] == [PID $61..PID $80] See below |  |  | 1 | 414008000000
61 | 97 | Driver demand: torque percentage (%) | 1 | -125 | 125 | % | A-125
62 | 98 | Final engine torque percentage (%) | 1 | -125 | 125 | % | A-125
63 | 99 | Engine torque reference in Nm | 2 | 0 | 65.535 | Nm | A*256+B
64 | 100 | Engine torque data in % | 5 | -125 | 125 | % | A-125 Idle
65 | 101 | Auxiliary inputs / outputs | 2 |  |  |  | Bit Encoded
66 | 102 | Flowmeter sensor | 5
67 | 103 | Engine water temperature in Â°C | 3
68 | 104 | Air temperature sensor in Â°C | 7
69 | 105 | Commanded EGR and EGR error | 7
6A | 106 | Commanded Diesel intake air flow control and relative intake air flow position | 5
6B | 107 | Recirculation gas temperature in Â°C | 5
6C | 108 | Commanded throttle actuator control and relative throttle position | 5
6D | 109 | Fuel pressure control system | 6
6E | 110 | Injection pressure control system | 5
6F | 111 | Turbocharger compressor inlet pressure in kPa | 3
70 | 112 | Boost pressure control in kPa | 9
71 | 113 | Variable Geometry turbo (VGT) control | 5
72 | 114 | Wastegate control | 5
73 | 115 | Exhaust pressure in kPa | 5
74 | 116 | Turbocharger RPM | 5
75 | 117 | Turbocharger A temperature in Â°C | 7
76 | 118 | Turbocharger B temperature in Â°C | 7
77 | 119 | Charge air cooler temperature in Â°C | 5
78 | 120 | Exhaust Gas temperature (EGT) Bank 1 | 9
79 | 121 | Exhaust Gas temperature (EGT) Bank 2 | 9
7A | 122 | Diesel particulate filter (DPF) bank 1 | 7
7B | 123 | Diesel particulate filter (DPF) bank 2 | 7
7C | 124 | Diesel Particulate filter (DPF) temperature | 9
7D | 125 | NOx NTE control area status | 1
7E | 126 | PM NTE control area status | 1
7F | 127 | Engine run time | 13
80 | 128 | List of PIDs supported (range 129 to 160) | 4
81 |  | Engine run time for Auxiliary Emissions Control Device(AECD) | 21
82 |  | Engine run time for Auxiliary Emissions Control Device(AECD) | 21
83 |  | NOx sensor | 5
84 |  | Manifold surface temperature | ?
85 |  | NOx reagent system | ?
86 |  | Particulate matter (PM) sensor | ?
87 |  | Intake manifold absolute pressure | ?
A0 |  | PIDs supported [A1 - C0] | 4
C0 |  | PIDs supported [C1 - E0] | 4
C3 |  | ? | ?
C4 |  | ? | ?

Sheet: KDS PID
PID | Description | Data bytes returned | Formula | Unit | Request | Response | Supported Z1000 | Supported Z750r | Operating Range
0 | List of PIDs supported1-32 | 4 |  |  | 80 11 F1 02 21 00 A5 | 80 F1 11 06 61 00 DF F7 87 87 CD
1 | Offen | 1 |  |  | 80 11 F1 02 21 01 A6 | 80 F1 11 02 61 01 05 ?? | 1 | 1
2 | Starter Switch | 1 |  | Bool | 80 11 F1 02 21 02 A7 | 80 F1 11 03 61 02 00 E8 | 1 | 1
3 |  |  |  |  |  |  | 0 | 0
4 | Throttle Position Sensor | 2 | ((a-Minimum) *100) / (Maximum - Minimum) | % | 80 11 F1 02 21 04 A9 | 80 F1 11 04 61 04 00 DE C9 | 1 | 1 | 0.2 ∼ 4.8 V | Min. 201, Max. 405 |  | (100/255)*Value
5 | Air Pressure (Inlet / Manifold) | 2 | ((a * 100) + b) / 2 | Pa | 80 11 F1 02 21 05 AD | 80 F1 11 04 61 05 7F 80 EB | 1 | 1 | Pv = 100 ∼ 900 mmHg
6 | Engine Coolant Temperature | 1 | (a - 48) / 1.6 | C | 80 11 F1 02 21 06 AB | 80 F1 11 03 61 06 70 5C | 1 | 1 | Tw = – 30 ∼ + 120°C
7 | Intake Air Temperature | 1 | (a - 48) / 1.6 | C | 80 11 F1 02 21 07 AC | 80 F1 11 03 61 07 45 32 | 1 | 1 | Ta = – 47 ∼ + 178°C
8 | Atmospheric Manifold Pressure | 1 | a / 2 | kPa | 80 11 F1 02 21 08 AD | 80 F1 11 04 61 08 C2 40 F1 | 1 | 1 | Pa = 100 ∼ 900 mmHg |  | Pa 760 mmHg (the standard atmospheric pressure)
9 | Engine RPM | 2 | (a * 100) + b | rpm | 80 11 F1 02 21 09 AE | 80 F1 11 04 61 09 0F 84 83 | 1 | 1
0A | Battery voltage | 1 | a / 12.75 | V | 80 11 F1 02 21 0A AF | 80 F1 11 03 61 0A B5 A5 | 1 | 1
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
81 |  |  |  |  | 80 11 F1 02 21 81 26 | 80 F1 11 03 7f 21 10 35 | 0 | 0
82 |  |  |  |  |  |  | 0 | 0
83 |  |  |  |  |  |  | 0 | 0
84 |  |  |  |  |  |  | 0 | 0
85 |  |  |  |  |  |  | 0 | 0
86 |  |  |  |  |  |  | 0 | 0
87 |  |  |  |  |  |  | 0 | 0
88 |  |  |  |  |  |  | 0 | 0
89 |  |  |  |  | 80 11 F1 02 21 89 2E | 80 F1 11 03 7f 21 10 35 | 0 | 0
8A |  |  |  |  |  |  | 0 | 0
8B |  |  |  |  | 80 11 F1 02 21 8B 30 | 80 F1 11 03 7f 21 10 35 | 0 | 0
8C |  |  |  |  |  |  | 0 | 0
8D |  |  |  |  |  |  | 0 | 0
8E |  |  |  |  |  |  | 0 | 0
8F |  |  |  |  |  |  | 0 | 0
90 |  |  |  |  |  |  | 0 | 0
91 |  |  |  |  |  |  | 0 | 0
92 |  |  |  |  |  |  | 0 | 0
93 |  |  |  |  |  |  | 0 | 0
94 |  |  |  |  |  |  | 0 | 0
95 |  |  |  |  |  |  | 0 | 0
96 |  |  |  |  |  |  | 0 | 0
97 |  |  |  |  |  |  | 0 | 0
98 |  |  |  |  |  |  | 0 | 0
99 |  |  |  |  |  |  | 0 | 0
9A |  |  |  |  |  |  | 0 | 0
9B |  |  |  |  | 80 11 F1 02 21 9B 40 | 80 F1 11 03 61 9B 00 ?? | 0 | 1
9C |  |  |  |  |  |  | 0 | 0
9D |  |  |  |  |  |  | 0 | 0
9E |  |  |  |  |  |  | 0 | 0
9F |  |  |  |  |  |  | 0 | 0
A0 | PIDs supported [A1 - C0] | 4 |  |  | 80 11 F1 02 21 A0 45 | 80 F1 11 06 61 9B 00 00 00 01 ?? | 1 | 1
C0 | PIDs supported [C1 - E0] |  |  |  |  |  | 1
E0 | Offen |  |  |  |  |  | 1

Sheet: Supported PIDs Z1000
PID | Aktiv | Description | Byte | Hex | Request | Response | Decimal
0 |  | List of PIDs supported1-32 | 1101 1111 1111 0111 1000 0111 1000 0111 | DF F7 87 87 | 80 11 F1 02 21 00 A5 | 80 F1 11 06 61 00 DF F7 87 87 CD
1 | 1 | Offen
2 | 1 | Starter Switch |  |  | 80 11 F1 02 21 02 A7 | 80 F1 11 03 61 02 00 E8
3 | 0 | 0
4 | 1 | Throttle Position Sensor |  |  | 80 11 F1 02 21 04 A9 | 80 F1 11 04 61 04 00 DE C9
5 | 1 | Air Pressure (Inlet / Manifold) |  |  | 80 11 F1 02 21 05 AD | 80 F1 11 04 61 05 7F 80 EB | 127 128 | 95
6 | 1 | Engine Coolant Temperature |  |  | 80 11 F1 02 21 06 AB | 80 F1 11 03 61 06 70 5C
7 | 1 | Intake Air Temperature |  |  | 80 11 F1 02 21 07 AC | 80 F1 11 03 61 07 45 32
8 | 1 | Atmospheric Manifold Pressure |  |  | 80 11 F1 02 21 08 AD | 80 F1 11 04 61 08 C2 40 F1 | 194 64 | 96
9 | 1 | Engine RPM |  |  | 80 11 F1 02 21 09 AE | 80 F1 11 04 61 09 0F 84 83
0A | 1 | Battery voltage |  |  | 80 11 F1 02 21 0A AF | 80 F1 11 03 61 0A B5 A5
0B | 1 | Gear Position |  |  | 80 11 F1 02 21 0B B0 | 80 F1 11 03 61 0B 00 F1
0C | 1 | Speed |  |  | 80 11 F1 02 21 0C B1 | 80 F1 11 04 61 0C 00 00 F3
0D | 0 | 0
0E | 1 | Injector #1 operating time |  |  | 80 11 F1 02 21 0E B3 | 80 F1 11 03 7f 21 10 35
0F | 1 | Injector #2 operating time |  |  | 80 11 F1 02 21 0F B4 | 80 F1 11 03 7f 21 10 35
10 | 1 | Injector #3 operating time |  |  | 80 11 F1 02 21 10 B5 | 80 F1 11 03 7f 21 10 35
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
8E | 0 | 0
8F | 0 | 0
90 | 0 | 0
91 | 0 | 0
92 | 0 | 0
93 | 0 | 0
94 | 0 | 0
95 | 0 | 0
96 | 0 | 0
97 | 0 | 0
98 | 0 | 0
99 | 0 | 0
9A | 0 | 0
9B | 1 | 0
9C | 0 | 0
9D | 0 | 0
9E | 0 | 0
9F | 0 | 0
A0 | 1 | PIDs supported [A1 - C0]
C0 |  | PIDs supported [C1 - E0]
C3 |  | #N/A
C4 |  | #N/A

Sheet: Supported PIDs Z750
PID | Aktiv | Description | Byte | Hex | Request | Response |  | Motor an
0 |  | List of PIDs supported1-32 | 1101 1111 1111 0111 1000 0111 1000 0111 | DF F7 87 87 | 80 11 F1 02 21 00 A5 | DF F7 87 87
1 | 1 | Offen |  |  |  | 05 |  | 05
2 | 1 | Starter Switch |  |  | 80 11 F1 02 21 02 A7 | 00
3 | 0 | 0 |  |  |  | Error
4 | 1 | Throttle Position Sensor |  |  | 80 11 F1 02 21 04 A9 | 00 C9 |  | 00 DA | 201 | 218
5 | 1 | Air Pressure (Inlet / Manifold) |  |  | 80 11 F1 02 21 05 AD | 88 | CC | 94 80 | 136 000 | 204 000 | 148 128 | 127 128
6 | 1 | Engine Coolant Temperature |  |  | 80 11 F1 02 21 06 AB | 88 | 44 | 6A
7 | 1 | Intake Air Temperature |  |  | 80 11 F1 02 21 07 AC | 45 | 44 | 45
8 | 1 | Atmospheric Manifold Pressure |  |  | 80 11 F1 02 21 08 AD | CB 80 |  | CB 80 | 203 128 |  |  |  | Ist praktisch gleichzusetzen mit MAF bei Autos
9 | 1 | Engine RPM |  |  | 80 11 F1 02 21 09 AE | 09 FA |  | 10 4D
0A | 1 | Battery voltage |  |  | 80 11 F1 02 21 0A AF | 9A |  | B7 | 154 | 183
0B | 1 | Gear Position |  |  | 80 11 F1 02 21 0B B0 | 00 |  | 00
0C | 1 | Speed |  |  | 80 11 F1 02 21 0C B1 | 00 |  | 00
0D | 0 | 0
0E | 1 | Injector #1 operating time |  |  | 80 11 F1 02 21 0E B3 | Error |  | Error
0F | 1 | Injector #2 operating time |  |  | 80 11 F1 02 21 0F B4 | Error |  | Error
10 | 1 | Injector #3 operating time |  |  | 80 11 F1 02 21 10 B5 | Error |  | Error
11 | 1 | Injector #4 operating time |  |  | 80 11 F1 02 21 11 B6 | Error |  | Error
12 | 0 | Injector #5 operating time |  |  | 80 11 F1 02 21 12 B7
13 | 0 | Injector #6 operating time |  |  | 80 11 F1 02 21 13 B8
14 | 0 | Injector #7 operating time |  |  | 80 11 F1 02 21 14 B9
15 | 0 | Injector #8 operating time |  |  | 80 11 F1 02 21 15 BA
16 | 1 | Ignition timing for cyl. #1 |  |  | 80 11 F1 02 21 16 BB | Error |  | Error
17 | 1 | Ignition timing for cyl. #2 |  |  | 80 11 F1 02 21 17 BC | Error |  | Error
18 | 1 | Ignition timing for cyl. #3 |  |  | 80 11 F1 02 21 18 BD | Error |  | Error
19 | 1 | Ignition timing for cyl. #4 |  |  | 80 11 F1 02 21 19 BE | Error |  | Error
1A | 0 | ECU ID |  |  | 80 11 F1 01 1A 9D |  | Kein Mode01 Befehl!
1B | 0 | 0
1C | 0 | 0
1D | 0 | 0
1E | 1 | CO adjust valve #1 |  |  | 80 11 F1 02 21 1E C3 | Error |  | Error
1F | 1 | CO adjust valve #2 |  |  | 80 11 F1 02 21 1F C4 | Error |  | Error
20 | 1 | List of PIDs supported 33-65 | 1100 0011 1110 0101 1110 0000 0001 1111 | C3 E5 E0 1F | 80 11 F1 02 21 20 C5 | C3 E5 E0 1F
21 | 1 | CO adjust valve #3 |  |  | 80 11 F1 02 21 21 C6 | Error |  | Error
22 | 1 | CO adjust valve #4 |  |  | 80 11 F1 02 21 22 C7 | Error |  | Error
23 | 0 | 0 |  |  |  | Error
24 | 0 | 0 |  |  |  | Error
25 | 0 | 0 |  |  |  | Error
26 | 0 | 0 |  |  |  | Error
27 | 1 | Offen |  |  |  | 00 |  | 00
28 | 1 | Offen |  |  |  | 00 |  | 00
29 | 1 | Offen |  |  |  | 00 |  | 00
2A | 1 | 0 |  |  |  | 00 |  | 00
2B | 1 | 0 |  |  |  | 00 |  | 00
2C | 0 | 0
2D | 0 | 0
2E | 1 | Offen |  |  |  | 00 |  | 00
2F | 0 | 0
30 | 1 | 0 |  |  |  | 00 |  | 00
31 | 1 | Offen |  |  |  | 00 |  | 00
32 | 1 | Offen |  |  |  | 00 |  | 00
33 | 1 | Offen |  |  |  | 00 |  | 00
34 | 0 | 0
35 | 0 | 0
36 | 0 | 0
37 | 0 | 0
38 | 0 | 0
39 | 0 | 0
3A | 0 | 0
3B | 0 | 0
3C | 1 | Offen |  |  |  | 00 |  | 00
3D | 1 | Offen |  |  |  | 00 |  | 00
3E | 1 | Offen |  |  |  | 00 |  | 00
3F | 1 | Offen |  |  |  | 00 |  | 00
40 | 1 | List of PIDs supported 66-96 | 1111 0000 0000 0000 0001 0100 0011 1111 | F0 00 14 3F | 80 11 F1 02 21 40 E5 | F0 00 14 3F
41 | 1 | Offen |  |  |  | Error |  | Error
42 | 1 | Offen |  |  |  | Error |  | Error
43 | 1 | Offen |  |  |  | Error |  | Error
44 | 1 | Total operating hours |  |  | 80 11 F1 02 21 44 E9 | 00 15 93 DD | 00 15 95 18 | 00 15 95 9D
45 | 0 | Offen |  |  |  | Error
46 | 0 | Offen |  |  |  | Error
47 | 0 | Offen |  |  |  | Error
48 | 0 | 0
49 | 0 | 0 |  |  |  | Error
4A | 0 | 0
4B | 0 | 0 |  |  |  | Error
4C | 0 | 0
4D | 0 | 0
4E | 0 | 0
4F | 0 | 0
50 | 0 | 0
51 | 0 | 0
52 | 0 | 0
53 | 0 | 0
54 | 1 | Offen |  |  |  | 00
55 | 0 | 0
56 | 1 | Anzahl Fehler im Diagnostic Modus??? |  |  |  | 03 |  | 03 | 3
57 | 0 | 0
58 | 0 | 0
59 | 0 | 0
5A | 0 | 0
5B | 1 | Sub-throttle valve operating angle |  |  | 80 11 F1 02 21 5B 00 | 51 |  | A9 | 81 | 169
5C | 1 | Offen |  |  |  | 00 |  | 00
5D | 1 | Offen |  |  |  | 00 |  | 00
5E | 1 | vehicle-down sensor voltage |  |  | 80 11 F1 02 21 5E 03 | CE |  | CE | 206
5F | 1 | internal control #2 Voltage |  |  | 80 11 F1 02 21 5F 04 | 9A |  | B9 | 154 | 185
60 | 1 | List of PIDs supported 97-128 | 1111 1111 0000 0111 0000 0000 0000 0001 | FF 07 00 01 | 80 11 F1 02 21 60 05 | FF 07 00 01
61 | 1 | internal control #3 Voltage |  |  | 80 11 F1 02 21 61 06 | 00 |  | 00
62 | 1 | Emergency Stop |  |  | 80 11 F1 02 21 62 07 | 00 |  | 00
63 | 1 | Offen |  |  |  | 00 |  | 00
64 | 1 | Offen |  |  |  | 00 |  | 00
65 | 1 | Offen |  |  |  | 01 |  | 01 | 1
66 | 1 | Choke??? |  |  |  | 69 | 96 | 69 | 105 | 150
67 | 1 | Offen |  |  |  | 2E | 2E | 2E | 46
68 | 1 | Offen |  |  |  | 01 |  | 01 | 1
69 | 0 | Offen |  |  |  | Error
6A | 0 | Fuel cut mode |  |  | 80 11 F1 02 21 6A 0F
6B | 0 | Engine starting mode |  |  | 80 11 F1 02 21 6B 10 | Error
6C | 0 | 0
6D | 0 | 0
6E | 1 | 0 |  |  |  | 00 |  | 00
6F | 1 | 0 |  |  |  | 00 |  | 00
70 | 1 | 0 |  |  |  | 00 |  | 00
71 | 0 | 0
72 | 0 | 0
73 | 0 | 0
74 | 0 | 0
75 | 0 | 0
76 | 0 | 0
77 | 0 | 0
78 | 0 | 0
79 | 0 | 0
7A | 0 | 0
7B | 0 | 0
7C | 0 | 0
7D | 0 | 0
7E | 0 | 0
7F | 0 | 0
80 | 1 | List of PIDs supported 129-? | 0000 0000 0000 0000 0000 0000 0010 0001 | 00 00 00 21 | 80 11 F1 02 21 80 25 | 00 00 00 21
81 | 0 | 0 |  |  |  | Error
82 | 0 | 0
83 | 0 | 0
84 | 0 | 0
85 | 0 | 0
86 | 0 | 0
87 | 0 | 0
88 | 0 | 0
89 | 0 | 0 |  |  |  | Error
8A | 0 | 0
8B | 0 | 0 |  |  |  | Error
8C | 0 | 0
8D | 0 | 0
8E | 0 | 0
8F | 0 | 0
90 | 0 | 0
91 | 0 | 0
92 | 0 | 0
93 | 0 | 0
94 | 0 | 0
95 | 0 | 0
96 | 0 | 0
97 | 0 | 0
98 | 0 | 0
99 | 0 | 0
9A | 0 | 0
9B | 1 | 0 |  |  |  | 00 |  | 00
9C | 0 | 0
9D | 0 | 0
9E | 0 | 0
9F | 0 | 0
A0 | 1 | PIDs supported [A1 - C0] |  |  |  | 00000001 |  | 1
C0 | 1 | PIDs supported [C1 - E0] |  |  |  | 001E1F07 |  |  |  | 61C0001E1F07
C1 | 0
C2 | 0
C3 | 0 | #N/A
C4 | 0 | #N/A
C5 | 0
C6 | 0
C7 | 0
C8 | 0
C9 | 0
CA | 0
CB | 0
CC | 1 | #N/A |  |  |  | Error
CD | 1 | #N/A |  |  |  | Error
CE | 1 | #N/A |  |  |  | Error
CF | 1 | #N/A |  |  |  | Error
D0 | 0
D1 | 0
D2 | 0
D3 | 0
D4 | 1 | #N/A |  |  |  | Error
D5 | 1 | #N/A |  |  |  | Error
D6 | 1 | #N/A |  |  |  | Error
D7 | 1 | #N/A |  |  |  | Error
D8 | 1 | #N/A |  |  |  | Error
D9 | 0
DA | 0
DB | 0
DC | 0
DD | 0
DE | 1 | #N/A |  |  |  | Error
DF | 1 | #N/A |  |  |  | Error
E0 | 1 | Offen |  |  |  | 40 |  |  |  | 61E0400000

Sheet: AT-Commands
Type | Command | Range | Meaning | Result | Linebreak | OK | Prompt
General Commands | <CR> |  | Repeat last Command
 | BDR hh |  | try Baudrate Divisor hh
 | BRT hh |  | set Baudrate Divisor hh
 | D |  | set all to Defaults
 | E | 0.1 | Echo off, on
 | FE |  | Forget Events
 | I |  | print version ID
 | L | 0.1 | Linefeed off, on
 | LP |  | go to Lower Power mode
 | M | 0.1 | Memory off, on
 | RD |  | Read the stored Data
 | SD hh |  | Save Data by byte hh
 | WS |  | Warm Start (quick reset)
 | Z |  | Reset all
 | @1 |  | display the device Description
 | @2 |  | display the device Identifier
 | @3 cccccccccccc |  | store the @2 identifier
Programmable Parameter | PP xx OFF |  | disable Prog Parameter xx
 | PP FF OFF |  | all Prog parameters disabled
 | PP xx ON |  | enable Prog Parameter xx
 | PP FF ON |  | all Prog parameters enabled
 | PP xx SV yy |  | for PP xx, Set the Value to yy
 | PPS |  | print a PP Summary
Voltage Reading | CV dddd |  | Calibrate the Voltage to dd.dd volts
 | CV 0000 |  | Restore CV value to factory setting
 | RV |  | Read input Voltage
Other | IGN |  | read the IgnMon input level
OBD | AL |  | Allow Long (>7 bytes) message
 | AMC |  | display Activity Monitor Count
 | AMT hh |  | set Activity Mon Timout to hh
 | AR |  | Automatically Receive
 | AT | 0,1,2 | Adaptive Timing off, Auto1, auto2
 | BD |  | perform Buffer Dump
 | BI |  | Bypass the Initialization sequence
 | DP |  | Describe Current Protocol
 | DPN |  | Describe Protocol by Number
 | H | 0.1 | Headers off or on
 | MA |  | Monitor all
 | MR hh |  | Monitor für Receiver = hh
 | MT hh |  | Monitor für Transmitter = hh
 | NL |  | Normal Length messages
 | PC |  | Protocol Close
 | R | 0.1 | Responses off, on
 | RA hh |  | set Receiver Adress to hh
 | S | 0.1 | printing of Spaces off or on
 | SH xyz |  | Set Header to xyz
 | SH xxyyzz |  | Set Header to xxyyzz
 | SH wwxxyyzz |  | Set Header to wwyyxxzz
 | SP h |  | Set Protocol to h and save it
 | SP A h |  | Set protocol to Auto, h and save it
 | SP 00 |  | Erase Stored Protocol
 | SR hh |  | Set Receiver Address to hh
 | SS |  | use Standard Search Order (J1978)
 | ST hh |  | Set Timeout to hh x 4 msec
 | TA hh |  | set Tester Address to hh
 | TP h |  | Try Protocol h
 | TPAh |  | Try Protocol h witch Auto search
J1850 | IFR | 0,1,2 | IFR off, auto or on
 | IFR | H,S | IFR value from Header or Source
ISO | FI |  | perform Fast Initialization
 | IB | 10,48,96 | Set ISO Baud rate to 10400, 4800, 9600
 | IIA hh |  | set ISO (slow) Init Address to hh
 | KW |  | display the Key Words
 | KW | 0.1 | Key Word checking off, on
 | SI |  | perform a Slow (5baud) Initiation
 | SW hh |  | Set Wakeup interval to hh x 20 msec
 | SW 00 |  | Stop sending wakeup messages
CAN | WM | 1-6 bytes | set the Wakeup Message
J1939

Sheet: SID
10 | Start Diagnostic Session
11 | ECU Reset
12 | Read Freeze Frame Data
13 | Read Diagnostic Trouble Codes
14 | Clear Diagnostic Information
17 | Read Status Of Diagnostic Trouble Codes
18 | Read Diagnostic Trouble Codes By Status
1A | Read Ecu Id
20 | Stop Diagnostic Session
21 | Read Data By Local Id
22 | Read Data By Common Id
23 | Read Memory By Address
25 | Stop Repeated Data Transmission
26 | Set Data Rates
27 | Security Access
2C | Dynamically Define Local Id
2E | Write Data By Common Id
2F | Input Output Control By Common Id
30 | Input Output Control By Local Id
31 | Start Routine By Local ID
32 | Stop Routine By Local ID
33 | Request Routine Results By Local Id
34 | Request Download
35 | Request Upload
36 | Transfer data
37 | Request transfer exit
38 | Start Routine By Address
39 | Stop Routine By Address
3A | Request Routine Results By Address
3B | Write Data By Local Id
3D | Write Memory By Address
3E | Tester Present
81 -> xx xx | Start Communication
82 | Stop Communication
83 | Access Timing Parameters
85 | Start Programming Mode | ControlDT-C-Setting | Hier kann beispielsweise innerhalb der Werkstatt bei Reparaturarbeiten die Fehlerspeicherung abgeschaltet werden.

Sheet: Service Codes
Service Code | Problems | Z750 | Z800
11 | Main throttle sensor malfunction, wiring open or short
12 | Inlet air pressure sensor malfunction, wiring open or short
13 | Inlet air temperature sensor malfunction, wiring open or short
14 | Water temperature sensor malfunction, wiring open or short
15 | Atmospheric pressure sensor malfunction, wiring open or short
16 | Intake Air Pressure Sensor #2 | No | Yes
21 | Crankshaft sensor malfunction, wiring open or short
23 | Camshaft position sensor malfunction, wiring open or short
24 & 25 | Speed sensor malfunction, wiring open or short
 | First 24 is displayed and then 25, repeatedly
31 | Vehicle-down sensor malfunction, wiring open or short
32 | Subthrottle sensor malfunction, wiring open or short
33 | Oxygen sensor inactivation, wiring open or short (Equipped Models)
34 | Exhaust butterfly valve actuator sensor malfunction, wiring open or short
35 | Immobilizer amplifier malfunction (Equipped Models)
36 | Blank Key detection (Equipped Models)
39 | ECU communication error
51 | Stick coil #1 malfunction, wiring open or short
52 | Stick coil #2 malfunction, wiring open or short
53 | Stick coil #3 malfunction, wiring open or short
54 | Stick coil #4 malfunction, wiring open or short
56 | Radiator fan relay malfunction, wiring open or short
62 | Subthrottle valve actuator malfunction, wiring open or short
63 | Exhaust butterfly valve actuator malfunction, wiring open or short
64 | Air switching valve malfunction, wiring open or short
67 | Oxygen sensor heater malfunction, wiring open or short (Equipped Models)
94 | Oxygen sensor malfunction, wiring open or short (Equipped Models)

Sheet: Raterei
PID | Decription | Hex | Dec | Value/Result | Full Close | Full Open
04 | Throttle Opening | DE | 222 | 1035 | 0.985 ∼ 1.015 V | 4.18 ∼ 4.38 V | Idle / full throttle
5B | Sub-Throttle | B6 | 182 | 1464 | 0.48 ∼ 0.52 V | 3.65 ∼ 4.38 V | Full Close / Full Open
0A | Battery | B5 | 181 | 12.19
5E | Vehicle Down | CF | 207 | 4023 | 0.65 ∼ 1.35 V | 3.55 ∼ 4.45 V | 60-70° / Upright
5F | Internal C #2 | B5 | 181 | 3046
61 | Internal C #3 | 7F | 127 | 2048
PIDs
Exhaust Butterfly
Radiator Fan
Air Switching Valve

Sheet: Test
 |  | Motor aus |  | Motor an |  | ~3000 RPM
PID | Decription | Hex | Dec | Hex | Dec | Hex | Dec
04 | Throttle | 00 C9 | 201 | 00 DD | 221 | 01 1B | 127
05 | Air Pressure | CE C0 | 206192 | A1 80 | 161128 | A2 00 | 162000 | 38Meter über NN
06 | Engine Coolant | 43 | 67 | 43 | 67 | 78 | 120 | 45° C | OK
07 | Intake Air Temp | 43 | 67 | 43 | 67 | 44 | 68 | 12° C | OK
08 | Athmospheric Air Pressure | CE | 206 | CE | 206 | CE | 206 |  |  |  | Pa = 100 ∼ 900 mmHg | Pa 760 mmHg (the standard atmospheric pressure) | = 101,3kPa
0A | Battery | 9B | 155 | B9 | 185 | B7 | 183
5B | Sub Throttle | 51 | 81 | C1 | 193 | B4 | 180
5F | Internal C2 | 9B | 155 | BA | 186 | B | 182
 |  |  |  | 6000RPM |  | >6000RPM
04 | Throttle | 00 C9 | 156 | 01 00 | 1 000 | 00 DC | 220
05 | Air Pressure | CC 80 | 204 128 | 7C 40 | 124 64 | 45 C0 | 69 192
06 | Engine Coolant | 42 | 66 | 75 | 117 | 93 | 147 |  |  | 147 = 60C | 61,8C (Berechnet)
07 | Intake Air Temp | 42 | 66 | 43 | 67 | 44 | 68
0A | Battery | 99 | 153 | B9 | 185 | 9C | 156 | 153 = 12V | 185 = 14,5V | 156 = 12,2V
5B | Sub Throttle | 51 | 81 | B6 | 182 | BD | 189 | 81 = 0% ??? = 100%
Throttle | 201 | 405
SubThrottle | 81 | 189
Throttle |  | 202
SubThrottle |  | 255
