HerrRiebmann/KDS2Bluetooth/(threads)

Thread 1 (2016-12-08):

Circuit Diagram

kamranshahidbutt, 2016-12-08:
Dear can you please share the circuit diagram how's we need to connect the circuit.

aster94, 2016-12-08:
Maybe you are looking for this one?

El 8 dic. 2016 10:14 PM, "kamranshahidbutt" <notifications@github.com>
escribió:

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

kamranshahidbutt, 2016-12-08:
Dear i am looking for Schematics

HerrRiebmann, 2016-12-09:
Hi, it is quite easy to wire up.
Connect Rx to Rx, Tx to Tx and VCC to 5V Output from Arduino. VCC, Gnd and K-Line to the Bike. A PullUp-resistor is needed between power supply (VCC) and K-Line!

It´s an old one I found, but maybe it helps:
[http://fs5.directupload.net/images/161209/axzt2a7a.jpg](url)
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

Anything else can be found here:
[https://github.com/HerrRiebmann/KDS2Bluetooth/blob/master/Documentation/Readme.md](url)

Gui13, 2017-01-14:
FWIW I have reproduced this schematic but had to reverse RX and TX for the bluetooth:
- HC06 RX connected to D10 and TX connected to D11

Otherwise the connection wouldn't work.

I still couldn't have the device speak with my bike (Versys 650). I could connect to it though.

@HerrRiebmann the pull up is needed between VCC (5V) or VIN (12V)?

Gui13, 2017-01-14:
Another guy on an American forum has posted what looks like a good version of the circuit:

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

The capacitor is 10nf and the resistor is 510 Ohms.

HerrRiebmann, 2017-01-19:
Yes, that is the right one!
I think you don´t need to connect the 5V to the L9637D. But it does not matter.
Rx to Rx and Tx to Tx. Normally it has to be twisted, but the L96...-label considered this already.

HerrRiebmann, 2018-01-22:
Updated the Readme on the [Dokumentation](https://github.com/HerrRiebmann/KDS2Bluetooth/tree/master/Documentation)-Section:
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

Snecer, 2018-02-06:
I am newbie and have a question about your new schematic.

I dont understand the "left" side of the shematic, is my schematic below ok?

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

HerrRiebmann, 2018-11-05:
If it easily would be possible just to connect a ELM327 (_or a cheap china clone_), do you think we all would spend so much time and work into that? ;)

Theoretically this might be possible. But you have to reconfigure the initial process, manually. Then change the timings, baud, SID´s, header, format and more. This is possible, but needs to be done via bluetooth somehow. Then you still do not have matching PIDs, nor the calculations will fit.
Whatever device you might connect then, will possibly reset these settings. If not, it will expect OBD II compatible values and ID´s. These cannot be configured on the ELM327.

Long story short: Might be possible, but needs some research and testing. And you cannot use any stock device to receive the data. You have to develop this yourself.

diaslemuel, 2018-11-06:
I do understand that your project was a task and i did get all the stuff to do it before i read another forum.

I just asked as some on the zx-10r forum managed to get that done and hence asked

FYI - The Links

https://www.zx-10r.net/forum/f23/clearing-ecu-codes-obdii-scanner-349538.html

https://www.zx-10r.net/forum/f23/obdii-zx10r-bluedriver-320554.html

HerrRiebmann, 2018-11-06:
This won´t work for any bike without EURO 4 homogenisation (_Which started 2017-01-01_).
I guess, that the 20**16** ZX10R was changed to OBD II protocol already.

As you can see in the video from the second link, the PID´s are pretty standard (0x0C for RPM). All Kawasaki´s (_Bikes, Jetski, ATV, ect._) between 2007-2017 use 0x09.
Also clearing the trouble codes would use SID 0x04 in OBD II, but 0x14 in KDS.

It seems, that the bikes now, really support OBD II, and you just need a plug/cable to make an ELM327 work. That was announced by law, but I never got any further information about this (_And if this is only be done in Europe_) until yet :)
Personally I´vent tried that due to the fact, I do not own a bike from 2017.

I got all the stuff here to create a plug for a few cents, without cutting any cable. Maybe I´ll contact my dealer :D

Snecer, 2018-11-06:
ZX10R is another story, that works for Gen5+ = 2016 models+

https://ftecu.com/shop/kds-to-obdii-adapter-harnsess/

diaslemuel, 2018-11-06:
The dealers here are not helpful. and I rely on the internet where it becomes even more confusing

Snecer, 2018-11-06:
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

another improved working diagram

diaslemuel, 2018-11-06:
how do i identify the pins of the L9637. The IC is way to small and as far as i see there is no marking of pin no etc

Snecer, 2018-11-06:
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

upper left is 1

HerrRiebmann, 2018-11-07:
>
> The dealers here are not helpful. and I rely on the internet where it becomes even more confusing
The dealer should not do anything, I want to test it myself with a borrowed bike :)

Exactly, the most L9637D´s does not have the cut in the top. They have a flat edge on one side.
It is very helpful to buy a SOIC Board, to solder the L9637 on. As you can see underneath @Snecer ´s image.

diaslemuel, 2018-11-25:
is these the correct resistors etc??
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

diaslemuel, 2018-12-30:
Do i need to update all 4 .io files to arduino??

Snecer, 2018-12-30:
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

yes, all 4

Snecer, 2019-01-01:
You should open all 4 sketches  (see my screenshot, 4 tabs), connect the device and press button send...

HerrRiebmann, 2019-01-01:
Try to use a Bluetooth Serial Monitor App. Then you can better see what happens!
Maybe you got the wrong Baud-Rate between the BT-Module and Arduino?
Try to use an example sketch, where you can send Data between Serial Monitor an BT-Module.

HerrRiebmann, 2019-01-08:
I think so, you have to [pullup](https://en.wikipedia.org/wiki/Pull-up_resistor) the dataline, to straighten the signal.

diaslemuel, 2019-03-03:
I have added the 20k and 10k as well as per the diagram above but doesnt seem to still read the ECU.

Should i try this instead of the american one shared by snecer??

Fyi - My motorcycle is a ninja 300 non abs
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

Snecer, 2019-03-03:
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

mine diagram is working

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

diaslemuel, 2019-03-03:
@Snecer did you get the board made?

HerrRiebmann, 2019-03-04:
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

I think you have to change RX & TX. Instead of other chips, L9637D is already twisted. So connect Rx to Rx and Tx to Tx. I wrote this correctly, but it was wrong in the (old) picture. Sorry about that!

Like @Snecer, I also connected them directly. Nice solution to connect both boards btw. :)

HerrRiebmann, 2019-03-05:
My current solution looks like that and it is capable of Kawasaki and with a different plug (the grey one), also Suzuki.
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
Unique PCB with standalone ATmega, but stock HC06 Bluetooth.

Doesn´t got any signal drops anymore, or something similar. Only a little overflow, going 16.000rpm on the Gsx-R...

diaslemuel, 2019-03-05:
Did you @HerrRiebmann and @Snecer get PCB boards made??

diaslemuel, 2019-04-02:
@HerrRiebmann @Snecer

Did you guys design a PCB board?? DO you have any design ready

HerrRiebmann, 2019-04-02:
Yes we both did. But mine was designed with a friend (_due to my lack of knowledge doing that_) and I do not have the source of the PCB design.
I guess Snecer´s image is very easy to adapt and redesign it yourself.

diaslemuel, 2019-04-02:
@HerrRiebmann I am facing the same issue when I attempted to design the PCB. I dont have a clue how to do it.

@Snecer - can you share the pcb image or design so i get one printed for me. Due credit will be given.

My attempt at trying to get the DIY board is nowhere hence a PCB with all things assembled may help

diaslemuel, 2019-04-13:
@Snecer Can you help

Snecer, 2019-04-13:
PCB was friend's design, will try to find the file.
another simple shema...

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
![Uploading WP_20180302_011.jpg…]()

Snecer, 2019-04-13:
https://youtu.be/XFqLPIQ9M2Y

HW works ok, but it seems that SW is not optimized, i also couldn't find a string for speed, must be different as for z750. Thats not a big issue, because gps has that data.

diaslemuel, 2019-04-13:
@Snecer Please do let me know if you find it. TY in advance

diaslemuel, 2019-05-19:
Any Update??

Snecer, 2019-05-19:
No. Find someone who can draw a PCB.

Snecer, 2019-08-14:
> @Snecer did you get the board made?

I've found someone, who will draw the PCB.

diaslemuel, 2019-08-15:
@Snecer that would be great. How do i contact

IAmOrion, 2019-08-31:
I've made this so far using Fritzing - does it look right? I want to make sure I've not missed anything or connected wrong? Once confirmed I will share Gerber Files to use with JLCPCB or what ever PCB company you want

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

Snecer, 2019-08-31:
excellent, will ask my friend, he is also working on pcb
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

IAmOrion, 2019-08-31:
> excellent, will ask my friend, he is also working on pcb

Thanks - that looks much better than mine!
I obviously don't know the voltage rating for the caps or resistors though hence using Through Hole for first version - if someone can let me know the capacitor voltage requirements and the resistor power requirements I can alter my design also :)

I have Eagle too - although for simplicity I use Fritzing.  Will your friend be willing to share his .brd and .sch files?

Snecer, 2019-08-31:
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

Here some .brd files (alpha version).
https://www100.zippyshare.com/v/V8Iv6KWb/file.html

IAmOrion, 2019-08-31:
> Here some .brd files (alpha version).
> https://www100.zippyshare.com/v/V8Iv6KWb/file.html

Awesome, thanks.  I was hoping they would contain the values of the resistors etc but it doesn't ha.  Sods law! It shows package details, but the value field has been left blank on all of them.

diaslemuel, 2019-09-15:
Hey @IAmOrion @Snecer @HerrRiebmann  Has there been any update. Cause I have shelved this DIY cause i dont know where i am going wrong. Probably I have got some diodes/resistors or wiring wrong i dont know. Unfortunately i dont have any friend who can help. Hence was looking forward to the board

IAmOrion, 2019-09-15:
> Hey @IAmOrion @Snecer @HerrRiebmann Has there been any update. Cause I have shelved this DIY cause i dont know where i am going wrong. Probably I have got some diodes/resistors or wiring wrong i dont know. Unfortunately i dont have any friend who can help. Hence was looking forward to the board

I changed my design as I managed to get a load of TH3122.4 chips off of AliExpress (Although I've yet to test them but others have reported they work as expected)
For my particular usage, I don't need bluetooth BUT if you did, I highly recommend using the Keywish Nano BLE - which is an Arduino Nano with built in Bluetooth

I'm too much of a PCB Design novice for Eagle or EasyEDA - but you're welcome to my Gerbers to get them produced.

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

JLCPCB will make 5 boards for $2 - shipping will obv depend on your location.  I paid just over £9 GBP to have 30 boards made and posted to the UK economy recorded postage

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

Still waiting for them to arrive :)

Gerbers:
[BMW K Line v4 (Resler Variant TH3122).zip](https://github.com/HerrRiebmann/KDS2Bluetooth/files/3613720/BMW.K.Line.v4.Resler.Variant.TH3122.zip)

For what it's worth, I *MAY* revisit this using the L9637D but I couldn't find enough info of the circuit required - I mean, I found dozens of circuits, but they never showed the capacitor values and I don't know enough to work out what I would need and I couldn't get anyone to reply to me so I stopped working on it.

This as far as I got with the L9637D (I can't remember is this is complete or not)

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

Gerbers:
[BMW K Line.zip](https://github.com/HerrRiebmann/KDS2Bluetooth/files/3613724/BMW.K.Line.zip)

Fritzing:
[BMW K Line.fzz.zip](https://github.com/HerrRiebmann/KDS2Bluetooth/files/3613727/BMW.K.Line.fzz.zip)

Mattbatt84, 2021-07-03:
So I have built this and connect tot he Bluetooth via Torque light. Could somebody let me know what connector and color wire I connect to on a 2011 Versys 650? I have power ground and have have traced back from my ECU for both the self diag terminal and the Kawasaki Self diag terminal. Is it the 6 pin connector or 4 pin? Cheers

Snecer, 2021-07-03:
check the link

https://www.alter.si/tema/majster-za-arduino.2635004/page-2

V V sob., 3. jul. 2021 ob 20:39 je oseba Mattbatt84 <
***@***.***> napisala:

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

Mattbatt84, 2021-07-04:
Is anyone using the Torque lite Android app? I have successfully connected to Bluetooth but seem to get any further than that. Does the app connect instantly or do you need to wait?

Snecer, 2021-07-05:
> Is anyone using the Torque lite Android app? I have successfully connected to Bluetooth but seem to get any further than that. Does the app connect instantly or do you need to wait?

I am using Torque Pro.
https://youtu.be/O3VYY08cjY0

HerrRiebmann, 2021-07-05:
Yes, I also use Torque lite, Car Scan and RaceChrono.
And my Garmin Virb XE, off course. Works fine, with the latest code from here.

Just did a completely rewrote of my code. Now with Suzuki & Kawasaki combined, much more performance and error-logging.
Plenty of settings to use the data raw, from storage, gear calculation, obd2 conform, and so on.
I want to release a lot of it, but I think I can´t publish everything.

So I will create a new repository with at least all the features from this one, but more relyable.
Stay tuned for new videos and a new repository in the next time. I´ll let you know here :)

Roughd1433, 2021-07-06:
@HerrRiebmann Great news. I currently have two bikes in the works and plan on building my own dashboards for each one. So a Suzuki port of the software is wonderful. Thank you for all your hard work. I might be able to bend metal to my will....code not so much :)

Mattbatt84, 2021-07-11:
After a lot of thinking my wiring was the issue I have used the emulator to check and all wiring and components are good the issue is the KLine coming from the bike. I even traced the kline back the to ecu based on the manual. Torque lite jut does not pick up that the bike is connected. I have a 2011 versys 650. Has anyone else had similar problems and found a solution?

HerrRiebmann, 2021-07-11:
@Roughd1433 you can see how it works on my Suzuki. Its much better then on Kawasaki, since I introduced a data storage.
It holds everything which comes at once and transferes the values amazingly fast one by one.
Kawasaki just gives you a single value, so you are limited to ~6 or 7 values per second.
https://www.youtube.com/watch?v=RrPropqd4N4

@Mattbatt84 oh, that reminds me of releasing the latest version of the emulator, as well!
The emulator works directly by serial. So there is no L9637D involved, which might is broken or in the wrong direction?!
I created another Arduino with the L9637D, so I can test with the emulator the same way. But you will need another powersource for the second arduino.
Checking the K-Line otherwise than with this device, is tough! You´d need an oscilloscope and something which triggers the K-Line. Or drive to a workshop, where they just clear your diagnostic codes, or something. This would proove the K-Line is right!
The Versys 650 should be similar to the ER650 or nowadays the Ninja 650. I can try the test that out. But I already know, the plug is slightly different.

Mattbatt84, 2021-07-12:
@HerrRiebmann You were right it was the L9637D. I must have popped it prototyping a new board. I am going to purchase a few more a well as a MC33199 and have a crack at using that as it has a  transmission Baud rate up to 200kBaud. See if makes a difference.  Will also publish the EASYEDA files once done so people can order from PCBway or JLPCB as there pick and place services will do all the little 0806 bits as the  I will be adding TX RX leds to the kline chip to diagnose nonsense like I have been having.

Mattbatt84, 2021-07-13:
This project is getting expensive. £30 for the boards £30 Parts £30 in broken prototypes. All to see error codes hahahahha.
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

HerrRiebmann, 2021-07-13:
Wow! That is really expensive!
I think I paid about 160€ for 20 assembled boards. Just without the HC-06 module and without wiring and plugs.
Did you tried https://jlcpcb.com ?

But don´t ask me about all my prototypes, parts and unassembled boards... I guess this could leave the three-digits ;)
That´s the definition of "hobby"!

But all in all, that board-design really looks good! Quite compact!

Mattbatt84, 2021-07-13:
I looked at jlpcp but they were quoting £135 for 5 boards pre assembled and 25% of the parts were not available. I went with boards only and parts I do not have from ebay. The costly bits were the ATMEGA32U4-MU £8 and L9637D £5. But I am also being impatient and paying premium for parts that are next day shipping soooooooo. If I was willing to wait I think I would be looking at £40 for 5 assembled boards.
Compact for a reason. I am going to pot them into encloses. Take full advantage of the ATMEGA and most parts 0603 footprint. Will also see if I can heat sink the whole board as the linear voltage regulator has not been heat efficient at all

padilia, 2022-10-05:
@Snecer link has expired, could you please share again?

Closed 2018-01-22.

Thread 3 (2021-02-11):

How to start

Heiner1967, 2021-02-11:
Hi,

first of all many thanks to your great work. I have a similar but different problem around K-Line and KWP2000.
In my case I have a old Porsche 996 converted into an electric car, and I like to read some K-Line information of the Klimacontroller to adjust its operation. Due to the conversion some ECU are simply not their anymore as there is no engine anymore ...only a new electric one.
I found out Porsche at the time works with K-Line and KWP2000. Basically I need now to find out the rest like you did for your bike.

I installed the ECU Reader but nothing arrieves at the Bluetooth Device - it would have been to easy I assume.

I get somehow the Code of ECU-Reader but have here a basic question, typically RX TX from one device should be connected to the opposite TX RX of a second device. Does this principle shall apply for the K-Line Chip as well as for the bluetooth Device? I see it differently in the documents and get confussed.

Then you have the file of K-Line and Sniffer, but I miss them being called from somewhere else, or I miss the definition of the pins whcih are needed nd which I only saw in ECU_Reader - what do i miss here.

In principle I would assume K-Line does the initialisation, then the sniffer would see whats their, only once this is recorded I could adjust ECU Reader with the relevant codes to do it's work. Is this basically right?

Many Thanks for your help on this one

kind regards

HerrRiebmann, 2021-02-15:
Okay! I think there is a little missunderstanding about the Sniffer.
It´s intention was to read the bluetooth commands, which an ELM327 App/or compatible device would usually send.
That was my startingpoint to figure out, which PID´s I have to convert from "Kawasaki" to "OBD". So basically it´s the other way around,.
But changing it should not be big deal. You just have to send the signal from the hardware serial to the software serial:
```
void setup() {
  // initialize both serial ports:
  Serial.begin(9600);
  Serial1.begin(9600);
}

void loop() {
  // read from port 1, send to port 0:
  if (Serial1.available()) {
    int inByte = Serial1.read();
    Serial.write(inByte);
  }

  // read from port 0, send to port 1:
  if (Serial.available()) {
    int inByte = Serial.read();
    Serial1.write(inByte);
  }
}
```
Arduino ID -> Examples -> 04 Communication -> MultiSerial
This example was made for an Arduino Mega with two hardware serials. Just change Serial1 to the Softwareserial.

RX / TX is exactly like you understood. But some manufacturers were clever enough, to lable what you should connect to. In that case it´s  not twisted.
To use
`SoftwareSerial bluetooth(8, 7);`
Connect HC06 RX to D7 and TX to D8.

The L9637D must be connected RX to RX and TX to TX.

With that setup, you can listen to what´s happening on the line now. Identifying which sender and receiver is important for you and which data will activate/deactivate you fan and stuff.
It should be possible to directly send messages into that connection.

PS: I´ve also seen your answer on the other Issue.

Heiner1967, 2021-02-18:
Hi, ok I can report some progress, I add a resistor towards HC-06 RX and another one toward grownd to reduce teh Voltage on RX of HC-06 to about 3.3V.
The HC06_Sniffer I get to work, so I see how the ELM 327 SW talk and what it believes by Car should respond to.

So far so good and it shows the comms work. /based on ECU-Reader I get ELM to connect but now Feedback from ECU, neither any chance to see what is going on.

Here I hoped for the sniffer modul to help out but have no clue how this would work. I miss in the ECU-Reader to see a kind of Log, I only have the Feedback from the ELM327 SW talking to Bluettoth and need it to give the right requests via Bluettogh to the car.

I would like to try your code above which makes sence, but need first to initislise, I would doubt that without anything that there is any communication from K-Line.

I guess I need now based on the Log from HC-06 Sniffer to add those commands into Code to see where and when it stops functioning.....

I hope that makes sense, hmmmm more complex then expected.....

Roughd1433, 2021-02-20:
Have you thought about the arduino library for Torque Pro. It allows you to
assign custom PIDs to drive gauges on the Torque dashboard and log them. I
have it on my radar for when I get round to building a custom dash for one
of my streetfighter builds.

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

HerrRiebmann, 2021-02-20:
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

That is good news :)

>
> Here I hoped for the sniffer modul to help out but have no clue how this would work. I miss in the ECU-Reader to see a kind of Log, I only have the Feedback from the ELM327 SW talking to Bluettoth and need it to give the right requests via Bluettogh to the car.
>
Like I´ve said, the intention from that sniffer was to see what´s up on the Bluetooth OBD-side. So there is not much you can reuse from that.

>
> I guess I need now based on the Log from HC-06 Sniffer to add those commands into Code to see where and when it stops functioning.....
>
Hmm, I see two possibilities:
1. Take the code from above and "sniff" whats going on between two working devices. Send the data via Bluetooth to a Phone or PC
2. Digg in the deep and take parts from "ECU Reader", like initialization sequence, checksum calculation, read and send functionality.

The second approach would presume knowledge about sender and receiver address. A possible initialization message and then the data messages themself.
If there would be any documentation, great. If not, there is not other possibility to skip approach no. 1.

However you will go on, you cannot just copy some code from here and make it work. It indeed will require some coding and try ´n error.

HerrRiebmann, 2021-02-20:
>
> Have you thought about the arduino library for Torque Pro. It allows you to assign custom PIDs to drive gauges on the Torque dashboard and log them. I have it on my radar for when I get round to building a custom dash for one of my streetfighter builds.
>

This would be a nice feature for data, which is not supported by OBD2. Like gear, which I cheated into engine load.
But I wanted to support as much ELM327 or OBD2 compatible devices as possible. So I stayed on the supported values.
And the most important thing for me was my Garmin Virb, which records videos and those data.

This version of my solution is aged quite well ;-) I currently have a newer version, which supports Kawasaki and Suzuki. And maybe in the future it will support Honda.
It´s possible to enable some kind of a "raw-mode". With that, you can use f.e. RaceChrono and calculate the data inside the application.
For Torque it would be a lot of work to add all those values with id´s, type and values. From my perspective a different project :-)

Nice to know that this exists. And where some requests might come from, which I could not identify in the past. Because I was only listening to "AT"-commands and expected anything else to be a hexadecimal value...
Thanks :D

Roughd1433, 2021-02-22:
This is the forum for Torque pro. I am only posting it as it is a mine of information of can bus and setting up custom pids and so on.
[https://torque-bhp.com/forums/?wpforumaction=viewforum&f=1.0](url)

bc996, 2022-02-07:
@Heiner1967  - I am also working with a Porsche 996 that is being converted to electric (mine is a 2003 Carrera 4S) and am attempting to communicate with the various control units to keep the car operating fully with the electric motor/controller.  Some communication is on CAN bus, but I am also trying to reed, decipher and communicate with the K-line transmissions.  Have you made any progress with the Porsche K-line?  Do you have any advice or direction that you can share?

Thanks
Brian

Heiner1967, 2022-02-08:
Hi @bc996,
no unfortuniatly I came no step further. I assume as many Controllers are removed in my car that this cause the nofunction of K-Line at all.
However my aim was to read from the Climatronic to get heating, AC and fan switched better fro the electric use, now i discovered there is a serial port, which might do the trick ( I still need to check but have no time in the moment)
My Electric engine controller feeds via serial connection a little display showing rotating values of various temperatures of the controller and engine. Thoe I read via Arduino nano and send a correspnding analog signal to my analog instruments. The old watertemp is now engine Temp, the original Oilpreassure is now controller temp divided by 10 ( value 0-5 represent 0-50 degree celsius.

bc996, 2022-02-08:
Thanks @Heiner1967 - sorry to hear that you were not able to get further with the K Line.  I'm not sure what year your 996 is, but the mark 2's (996.2 - from 2002+) have the climatronic on a CAN bus.  That might be easier than K line anyway

HerrRiebmann, 2022-02-09:
Nice to read from you two guys :)
For newer motorbikes I´ve created some kind of sniffer, based on an ESP32. It writes anything from K-Line and/or CAN-Bus onto a SD card.
Similar schematic with the L9637D, connected to Rx2 & Tx2 and a CAN-Shield (MCP2515).
Maybe it would help to also create one of these and just see what´s happening on the wire(s).

From my point of view, that´s the most important part, to record some data. Before everything is torn apart ;)

Closed 2024-02-04.

Thread 8 (2023-09-07):

Support for ESP32

SaLuci, 2023-09-07:
I've got some ESP32 laying around, so instead of buying a HC-06 id like to use one of those.
Should be as simple as changing
`SoftwareSerial BT (8,7)`
To
`BluethoothSerial BT` (and including the BluetoothSerial library)

Obviously the BT Commands wont work, but that shouldn't be a problem, right? (I guess id have to delete/rewrite the corresponding code)

I cant test it right now, since im not home.
Just wanted your opinion.

Thank you for taking the time and documenting your code (and making it available to the public) really appreciate it.

HerrRiebmann, 2023-09-08:
Hi, yes that is definitely possible.
I also already done it for testing purpose. You also need to uncommented the RAM size and temperature calculation. The compiler warnings will lead you to those lines 💪🏻
I'm on vacation right now and cannot give you more advice.
But that's easy and you will make it anyways 😎

SaLuci, 2023-09-08:
Thank you for the response.
I'll keep that in mind.

Im closing the issue now

Closed 2023-09-08.

Thread 9 (2024-11-28):

Cannot connect to Car Scanner ELM OBD2？

Okita-Sawa, 2024-11-28:
I connected to Car Scanner ELM OBD2, but it disconnected for a few minutes and then wouldn't connect again.I re-uploaded the firmware, replaced the new Arduino and the new l9637d, but it still can't connect to the Car Scanner ELM OBD2.
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
This is a screenshot of XT Commands, it seems it can communicate with the ecu?

HerrRiebmann, 2024-11-29:
Hi,
I tested the solution with this exact Application and it worked fine.
But what I see is that you have some things quite strange:
Throttle and SubThrottle seem to be strange.
RAW-Mode is active, which removes the (in this case) Kawasaki specific conversions and just channels the commands from the Car Scanner Application.

So I´d set the Kawasaki Protocol again, by `XTP01` to have Throttle and stuff straight.
Then deactivate the Raw mode by `XTR0`
`XTE `shows the last errors, which might help. But due to the already wrong setup, I´d clear the error storage first by `XTER`

Strange that "Storage" is set to true as well. This should only be true when another arduino is connected, to write anything onto an SD-Card. Or if it was set manually. This would require a unique solution, which I used for debugging and testing purposes.

See all the other XT commands for setting up the device here:
https://github.com/HerrRiebmann/KDS2Bluetooth/tree/master/Bike_Diagnostic_System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

Which Bike do you have?

Okita-Sawa, 2024-11-30:
Thanks!
I restored the connection using XT Commands.It's working properly now.
I found the problem. There is something wrong with the plug that connects to the vehicle. The vibration will cause the k-line to be disconnected when driving on the road.If you do not restart the Arduino at this time and click on the connection of the APP, it will enter "connecting to ecu using protocol" and it will not recognize the protocol.Then restart Arduino and enter XT Commands, RAW-MODE will become TRUE.After executing the XT Commands you provided, the APP can successfully connect again.
My bike is 2017 kawasaki z250.

HerrRiebmann, 2024-12-01:
Ahh, allright! That habit sounds strange, but understandable :)
I think I test a lot, but not disconnecting the ECU with the App still running. At least not this one.
My camera just goes on requesting and I got about 3-4 seconds no data.

But I might test this tomorrow with my emulator. Maybe we can find an easy fix to not mess up all the settings.

HerrRiebmann, 2024-12-01:
And if you like to, please run a test procedure and give me the results?
This would be amazing! I got lots of examples but still try to figure out some magic 👯

**XTT1** -> Set Debug Mode to output everything
**XTZ** -> TestMode (ECU Id, & All PID´s)

If possible, run XTZ once with the engine off and again with the engine turned on.
The Serial Bluetooth Terminal has a function to log to a file. This will be needed to catch all data.
I might give you some more insights about you bike then.

Okita-Sawa, 2024-12-03:
Of course, but I'm on vacation now and will get back to you in a few days.:)

Thread 10 (2025-07-11):

Suzuki

chester2400, 2025-07-11:
How do you configure the ecu reader to read from suzuki motocycles?

HerrRiebmann, 2025-07-16:
You can use the latest Code in this folder:
https://github.com/HerrRiebmann/KDS2Bluetooth/tree/master/Bike_Diagnostic_System
scrolling right to the bottom, there are many commands to configure the device.
Best way to do so is to use a Bluetooth Terminal App (like Serial Bluetooth Terminal).

Then you can send `XTP03` to set it to Suzuki.
But it should also automatically find the right protocol in the first connection (when an application initializes with ATFI or something).

HerrRiebmann, 2025-07-16:
The hardware is described on the first page:
https://github.com/HerrRiebmann/KDS2Bluetooth?tab=readme-ov-file#hardware
You cannot connect the 12volts K-Line to the 5V Arduino or 3.3V ESP. A L9637D will convert the singleline signal to Rx/Tx and use the voltage as a reference. Then you need a seperate power supply or reduce and clean the voltage from the bike.

A Schematic can be found here:
https://github.com/HerrRiebmann/KDS2Bluetooth/tree/master/Documentation

Closed 2025-09-24.

Thread 11 (2025-07-28):

Can't connect to Torque Pro or ECU

mangomctango, 2025-07-28:
Howdy!
I have a 2015 Kawasaki Versys 650 and I'm having zero luck connecting to the the ECU or Torque using a Samsung S25 Ultra - Android 15. I've basically given up.

Here's a quick description of the issues.

1. I followed these threads and still nothing.

2. HC06 wont connect to Torque. It does not show up in Torque unless the SBT app has it connected.

3. I'm able to communicate with the Arduino and I can set it up using the XT/BT/AT commands. I changed the protocol to Kawasaki 1 and Kawasaki ABS with no change.

4. I tried two L9637D and even flipped and flopped wiring just incase the L9637D has been incorrectly described in the AliExpress description.

5. I tried two Nanos and two HC06s. With Bike-Diagnostics inos and the old ECU Reader inos.

6. See attached screenshots.

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

mangomctango, 2025-07-30:
Sadly, nothing had changed. But I will rewire the whole thing this weekend.

I'll let you know if anything changes.

mangomctango, 2025-08-08:
I redid the whole thing and checked continuity and voltages and it all checks out. But nothing changes.

Only 2 things I can think of. I killed both L9637Ds or the ECU address isn't correct.

So I can only think of 2 things.

1- Test the L9637D if it alive. ChatGPT has a list that I'll follow.

[Notes_250808_100453.txt](https://github.com/user-attachments/files/21688829/Notes_250808_100453.txt)

2- Have the arduino find the correct ECU address by scanning addresses from 0x00 to 0xZZ. Code's courtesy of Copilot.

[Code.txt](https://github.com/user-attachments/files/21688877/Code.txt)

mangomctango, 2025-08-12:
Thank you! Do you have a PayPal donation link?

I will try to go through with this this week.

I also bought more L9637Ds just in case.

$9.50 | 10pcs/lot L9637D013TR L9637DTR L9637D L9637 SOP-8 In Stock
https://a.aliexpress.com/_m0NTqq1
