HerrRiebmann/KDS2Bluetooth/(commit log)

2015-11-05 Initial Upload
    Arduino Projects
2015-11-05 Initial Upload
    Documentation files:
    OBD<->KDS PID-List
    ELM327
    ISO-Protocol
    L9637 Scematic
    [OBD II PIDs.xlsx]
2015-11-13 Throttle & Throttle Valve
    Throttle Calculation Updated
    Sniffer changed for testing
2015-11-13 Improve Calculation
    Improved calculation and valid value ranges in ECU Emulator.
    Optimized Intake & barometric pressure calculation in Arduino Sketch
    ECU_Reader
    [OBD II PIDs.xlsx]
2015-11-21 Throttle > 100% Fix | LCD Support
    LCD Code included but commented. The according librarys are to big :(
    they had to be reduced first.
    [ECU_Reader.ino, ELM327.ino]
2015-12-31 Throttle max value
    Throttle maximal value is now dynamical and gets stored onto the EEPROM.
    Avoid some possible zero divisions.
    [ECU_Reader.ino, ELM327.ino]
2016-03-09 Sub Throttle valve Sensor
    Some optimizations and storing the max values to eeprom
2016-06-22 Improved calculations and stability
    Removed LCD
    Optimized Calculations
    Optimized Stability
    Added possibility to use diagnostic-features
    And much more...
    [ECU_Reader.ino, ELM327.ino, HC06_Sniffer.ino, KLine.ino, Sniffer.ino]
2016-07-01 Updated ServiceCodes
    [OBD II PIDs.xlsx]
